tekrantz57/Drag/docs/CONTROLLER_FIRMWARE_UPDATE.md

# Controller Firmware Updates

DragWin can install bundled DragMC application firmware on a Mega 2560 or an
Arduino Due using its **Programming USB port only**. Each board has its own
validated package and uploader. On October 20, 2026, the operator successfully
flashed both the Due and an Elegoo Mega through DragWin on native Windows.
Due updater support is current-source work, not included in beta.2 downloads;
Due/bossac Wine qualification and deliberate failure/recovery tests remain pending.

## Operator Workflow

Current source checks the identified controller against its board's validated
bundled firmware package, offline. If the bundled version is newer, a persistent
amber notice below the connection controls shows the board and installed/available
versions, with **Update firmware...** opening the same updater as the File menu.
This feature is not in the beta.2 downloads. Nothing is automatically flashed.

Mega and Due versions are compared separately and numerically. Equal/newer
controllers, unidentified/unsupported products, unparseable versions, missing
packages, and ambiguous packages do not receive a guessed update offer. Package
validation failures are recorded in controller activity without a popup. Reconnect
to retry a check after repairing the local package files. Due light-test and Due
race firmware are different product version series; migration remains available
through the File menu rather than a misleading numeric update comparison.

The notice disappears on disconnect and is suppressed in demo mode. It stays
visible, but its update action is disabled, while update safety checks fail.
The File menu follows the same checks: close practice/tournament/diagnostic
windows, finish any known armed/running pass, and wait for a fresh idle heartbeat.
An idle-looking heartbeat does not clear an arm acknowledged earlier in the same
connection. An unidentified sketch can still use explicit manual board selection.
The updater rechecks controller safety after tool acquisition before releasing USB.

1. Connect the controller by USB and select its COM port in DragWin. For Due,
   use the connector nearest the round power jack, not Native USB. The current
   bench PC uses COM21 for Due Programming and COM26 for the Elegoo Mega;
   COM24 is the Due Native connector. Port numbers are machine-specific.
2. Close Practice Pass Results. Tournament and Sensor Test windows must also
   be closed before returning to the main window.
3. Choose **File > Update Controller Firmware...**.
4. Verify the displayed board, DragMC version, and COM port.
5. If DragWin cannot identify the existing sketch, explicitly choose the board
   type and physically confirm it is on the selected port. Nothing is selected
   by default. A known incompatible identity is rejected instead of overridden.
6. Keep USB connected while DragWin writes, verifies, reconnects, and requests
   the expected DragMC identity.

The update has three possible outcomes:

- **Updated:** the uploader verified flash and DragWin received the expected
  product, version, and MCU identity (Mega `DRAG_MC`/`MEGA2560`, Due
  `DRAG_MC_DUE`/`SAM3X8E`).
- **Written but not confirmed:** the uploader verified flash, but DragWin did not
  receive the expected identity within 20 seconds. Check the selected port and
  power-cycle the controller. This is not reported as a confirmed update.
- **Failed:** no successful upload was reported. DragWin shows the useful final
  uploader output and attempts to reopen the previous serial connection.

For Due, the 1200-baud Programming-port reset/erase occurs before bossac writes.
An interrupted update can leave no application running; repeat the upload with
DragWin's explicit board confirmation or Arduino IDE/CLI. The current firmware
version need not increase for an intentional reinstall. Both the full Due race
identity and the older light-only Due sketch select the Due **race** package;
updating replaces the diagnostic sketch, not the board's ROM bootloader.

## Supported Recovery

The updater supports a Mega that has its normal bootloader but currently runs
no DragMC sketch, a different sketch, or an application damaged by an
interrupted upload. Compatible clones are supported when their USB-to-serial
interface exposes a working COM port and their bootloader implements the Mega
`wiring` upload protocol.

The updater cannot repair a missing or damaged bootloader. Restore that with an
ISP programmer and Arduino tooling before using DragWin. The normal updater
never writes a `with_bootloader.hex` image and never disables the ATmega2560
signature check or flash verification.

The Due path uses its Programming-port interface and SAM ROM bootloader. It
does not implement Native USB port discovery/re-enumeration or any native Linux
uploader. Never select a Mega package for a Due or a Due package for a Mega.

## Uploader Acquisition

DragWin uses `avrdude.exe` and `avrdude.conf` as a matched pair. It checks, in
order:

1. `DRAGWIN_AVRDUDE_PATH` and optional `DRAGWIN_AVRDUDE_CONFIG` development
   overrides.
2. `%LOCALAPPDATA%\dragWin\Tools\avrdude\8.0.0-arduino1`.
3. avrdude installations under Arduino package directories.
4. The pinned official Arduino Windows archive, downloaded only after the
   operator approves the firmware-update confirmation.

The official archive's byte count and SHA-256 are pinned in source and checked
before extraction. avrdude is GPL-licensed; source and license information are
available from [the avrdude project](https://github.com/avrdudes/avrdude). The
tool archive is supplied by [Arduino Downloads](https://downloads.arduino.cc/).

Due updates use **bossac 1.6.1-arduino**, the version declared by Arduino SAM
Boards 1.6.12. Lookup order is `DRAGWIN_BOSSAC_PATH` (development override),
`%LOCALAPPDATA%\dragWin\Tools\bossac\1.6.1-arduino`, then that exact installed
Arduino tool version. Otherwise DragWin downloads the official Windows archive
after confirmation, verifies its pinned size (222,918 bytes) and SHA-256, and
extracts only `bossac.exe`. The override must be compatible with the SAM
Programming-port recipe; arbitrary newer bossac versions are not auto-selected.
No Arduino IDE installation is needed when downloading the pinned uploader.

## Wine Compatibility

The results below qualify only the **Mega/avrdude** path. The new Due/bossac
workflow, its 1200-baud reset, and its 32-bit Windows uploader need separate
Wine qualification on both Intel and ARM64 Linux.

The updater has been verified from the self-contained Windows x64 DragWin
release under Wine 11 on an Intel Linux system. In the tested setup, the Mega
appeared as `/dev/ttyACM0` and was mapped to `COM33` in the default Wine prefix:

```bash
ln -s /dev/ttyACM0 ~/.wine/dosdevices/com33
```

DragWin connected through `COM33`, downloaded and validated the pinned Windows
`avrdude` archive, and successfully flashed the bundled DragMC firmware. A
different Wine prefix or COM number can be used by changing the symlink path
and selecting the corresponding port in DragWin. The Linux account must have
permission to open the underlying serial device.

The separate Windows ARM64 DragWin release has also been verified running
natively under ARM64 Wine 11 on a Rock 5B, without x64 emulation or CPU
translation for DragWin itself. From that ARM64 environment, DragWin also
connected through `COM1`, downloaded and validated the pinned Windows `avrdude`
package, and successfully updated the controller firmware. That uploader is the
pinned Windows 32-bit `avrdude.exe` and ran under Wine; the update did not use
native Linux avrdude.

## Developer Packaging

Firmware versioning is defined in `dragMC/FirmwareVersion.h`. Build the current
Mega package from the repository root:

```powershell
powershell.exe -NoProfile -ExecutionPolicy Bypass -File `
  .\tools\Build-ControllerFirmware.ps1 `
  -ArduinoCliPath "C:\Program Files\Arduino CLI\arduino-cli.exe"
# Also build the independent Due package:
.\tools\Build-ControllerFirmware.ps1 -Board Due
```

The script:

- requires the installed `arduino:avr` core;
- compiles `arduino:avr:mega:cpu=atmega2560`;
- selects only `dragMC.ino.hex`;
- validates the version source and captures the core version;
- records the image byte count and SHA-256;
- writes `dragMC/dist/DragMC-mega-<version>.dragfw`; and
- leaves ignored build intermediates under `artifacts/controller-firmware`.

The `.dragfw` ZIP contains exactly `manifest.json` and `dragMC.ino.hex`.
DragWin validates its product, board profile, MCU, uploader settings, image
name, size, SHA-256, Intel HEX records, checksums, and EOF before releasing the
COM port. Publishing fails when the package matching `FirmwareVersion.h` is
absent. Build and commit the generated package with the exact firmware source
that produced it.

`-Board Due` requires the `arduino:sam` core and compiles
`arduino:sam:arduino_due_x_dbg`. Its version comes from
`DRAGMC_DUE_FIRMWARE_VERSION` in the same header. It packages only
`dragMC.ino.bin` as `DragMC-due-<version>.dragfw`, leaving Mega packages intact.
Due manifests are whitelisted separately, including product/MCU, Programming
Port FQBN, bossac backend and reset baud. DragWin checks the BIN size, hash and
SAM3X8E stack/reset vectors; a HEX, Native USB profile, wrong board tuple,
malformed image, duplicate package or cross-board selection is rejected before
upload. Publish now requires packages matching both firmware version macros.
