tekrantz57/Drag/docs/BUILDING.md

# Building From Source

Drag is distributed as source and as experimental self-contained Windows beta
packages through GitHub Releases. See [Try It Without Hardware](TRY_DEMO.md).

## Prerequisites

- .NET 10 SDK on Windows.
- Arduino CLI.
- Arduino AVR Boards core for the Mega 2560.
- Visual Studio is optional.

Install or update the Arduino index and AVR core:

```powershell
arduino-cli core update-index
arduino-cli core install arduino:avr
```

## Windows Application

From the repository root:

```powershell
dotnet restore dragWin\dragWin.sln
dotnet build dragWin\dragWin.sln -c Release --no-restore
dotnet run --project dragWin\dragWin.ProtocolTests\dragWin.ProtocolTests.csproj -c Release --no-build
dotnet format dragWin\dragWin.sln --verify-no-changes --no-restore
python -m unittest tools\test_drag_speech_helper.py
```

The protocol runner includes tournament UI, dial-input, and interrupted-round
recovery regression tests. CI also compiles a host harness against the actual
Mega sketch to test result delivery with a full queue and slow serial output:

```sh
g++ -std=c++17 -I tools/firmware-tests tools/firmware-tests/results.cpp -o /tmp/drag-firmware-tests
/tmp/drag-firmware-tests
```

These host tests exercise firmware logic with simulated pins and serial;
physical timing and electrical behavior still require track testing.

Run DragWin from source with:

```powershell
dotnet run --project dragWin\dragWin.csproj -c Release
```

## Mega Firmware

Compile the sketch directly:

```powershell
arduino-cli compile --fqbn arduino:avr:mega:cpu=atmega2560 dragMC
```

Create the versioned application-only `.dragfw` package used by DragWin:

```powershell
powershell.exe -NoProfile -ExecutionPolicy Bypass -File `
  .\tools\Build-ControllerFirmware.ps1
```

The packaging script reads `dragMC/FirmwareVersion.h`, compiles the Mega image,
records its size and SHA-256, validates the package metadata, and writes the
matching file under `dragMC/dist`. Commit a changed package only with the exact
firmware source that produced it.

## Local Self-Contained Builds

These commands create local test folders; they do not create an official Drag
release:

```powershell
dotnet publish dragWin\dragWin.csproj -c Release -r win-x64 `
  --self-contained true -p:PublishSingleFile=false `
  -o artifacts\release\DragWin-win-x64

dotnet publish dragWin\dragWin.csproj -c Release -r win-arm64 `
  --self-contained true -p:PublishSingleFile=false `
  -o artifacts\release\DragWin-win-arm64
```

Keep the complete publish directory together. DragWin expects its .NET runtime,
native SQLite library, `Firmware` directory, and packaged
`Linux/drag-speech-helper.py` to remain beside the executable. Piper itself and
voice models are optional external installations and are not published by Drag.

## Clean-Clone Check

Before treating a commit as a public validation point:

1. Build the solution in Release configuration.
2. Run the protocol tests and formatting check.
3. Compile and package DragMC for the Mega 2560.
4. Confirm the source tree contains no database, log, report, backup, credential,
   IDE-user, or machine-local files.
5. Follow only the commands in this document from a clean checkout.

## Tagged Beta Packages

After validation, commit the version and release notes and tag that exact
commit (for example, `v0.10.0-beta.1`). From that clean, tagged checkout:

```powershell
powershell.exe -NoProfile -ExecutionPolicy Bypass -File .\tools\Build-Release.ps1
```

The script publishes self-contained x64 and ARM64 folders, adds the demo
launcher, simple getting-started notes, licenses and source-commit metadata,
rejects personal data and debugging files, and creates ZIPs plus SHA-256
checksums under a fresh `artifacts/release` directory. It does not upload,
create tags, or edit the source. Attach only the ZIPs and checksum file to a
GitHub prerelease, using the matching release-notes document.

Validate each package with `tools/Test-ReleasePackage.ps1`, passing its ZIP and
the generated checksum file. Add `-LaunchDemo` for x64 startup testing on an x64
Windows host. Current packages must also contain the beta feedback notes and
commissioning worksheet. Inspect ARM64 packages here, then runtime-test them on
an ARM64 machine before claiming that platform has been validated.

To retain non-private report fixtures for print QA, set `DRAG_REPORT_TEST_OUTPUT`
to a local output folder before running the protocol tests. The test runner
writes a normal demo report and a 120-row long-name print stress report there.
