tekrantz57/Drag/docs/TROUBLESHOOTING.md

# Troubleshooting

## Controller Port Does Not Appear

Close Arduino Serial Monitor and any other program using the Mega, reconnect
USB, select **Refresh ports**, and choose the resulting COM port in DragWin.
Only one process can own the serial port at a time.

Under Wine, map the Linux serial device into the Wine prefix and select that COM
name in DragWin. For example:

```bash
ln -s /dev/ttyACM0 ~/.wine/dosdevices/com33
```

The COM number is local configuration, not a Drag requirement. Testing used
`COM33` on Intel Linux and `COM1` on the ARM64 Rock 5B. The Linux account must
have permission to open the underlying `/dev/ttyACM*` or `/dev/ttyUSB*` device.

## Sensor Randomly Shows Blocked

The installed LM393 sensors are active-HIGH. An unwired Mega input can float
and appear blocked. Connect the sensor output and common ground, or install the
documented 10k pulldown from the Mega input node to ground. Disable optional
interval sensors for lanes where they are not physically installed.

## Sensor Test Changes But A Pass Does Not Complete

Confirm that only the intended lanes participate and that the required beams
occur in race order: staging, launch, speed trap, then finish. In
`BOTH_BLOCKED`, pre-stage and stage must be blocked together. `IN_ORDER` is a
manual-testing alternative that latches pre-stage before stage.

Use Sensor Test to inspect each input's raw blocked-edge count and most recent
blocked-pulse duration. Firmware 0.6.6 and earlier require 2 ms qualification
for speed-trap and finish, which rejected short pulses during venue testing.
Current source firmware 0.6.7 captures their first sampled blocked edges and
latches each race timestamp once. Staging and interval inputs remain debounced.

In Sensor Test, reset counts before a test, note edge-count increments and pulse
widths, then click Read Scan Timing afterward (protocol 10+). The requested
maximum scan-start gap and scan duration help assess polling; they do not prove
that an electrical pulse was produced or guarantee that every pulse was sampled.
If no raw edge is captured, investigate optical/electrical output versus polling
with a scope or logic analyzer. Restore normal A2/A3 wiring before timed passes
if the inputs were swapped for diagnosis.

## Tree Lights Stay On Or Off During Light Test

The Mega's D22-D53 double-row header has two +5V positions immediately before
D22 and D23. Use the labels printed on the board instead of treating the end of
the connector as D22/D23. LEDs accidentally connected to the +5V pair remain on
regardless of Light Tree Test commands, while a jumper on the wrong digital pin
may remain off or respond to a different control.

Confirm questionable outputs by moving a known-working LED and resistor to the
labeled pin, or measure the pin relative to Mega GND while toggling it. Keep the
Light Tree Test window open during measurement; after it closes, D22 and D23
return to their normal pre-stage and stage sensor behavior.

## Status Or Diagnostic Frames Are Missing

Open Controller Diagnostics or press the appropriate status command in the
main window. The serial log records traffic that was actually requested or sent;
simply opening the serial log does not continuously request every diagnostic
frame.

## Firmware Update Cannot Identify The Existing Sketch

The updater can recover a Mega with a normal USB bootloader even if it runs a
different sketch. Physically verify that the selected port belongs to the Mega
before using the manual confirmation path. The updater cannot repair a missing
or damaged bootloader; that requires an ISP programmer and Arduino tooling.

See [Controller Firmware Updates](CONTROLLER_FIRMWARE_UPDATE.md) for uploader
selection, validation, recovery boundaries, and Wine results.

## Voice Is Unavailable Under Wine

DragWin can use SAPI voices installed in the Wine prefix, Piper, or the
packaged native Linux eSpeak NG helper. See
[Linux Speech Under Wine](LINUX_SPEECH.md) for engine selection and eSpeak
diagnostics. Speech is optional and an unavailable engine does not affect race
timing or controller operation.

## No Piper Voices Appear

Installing `piper-tts` does not install a voice. Download both the `.onnx`
model and `.onnx.json` configuration into Drag's Piper voice directory. On
native Windows, confirm that `python` starts the environment where Piper was
installed. Under Wine, start the helper natively with `--engine piper --port
38593` before opening Race and Track Settings.

If Piper was installed with pipx, system `python3` cannot import it. Run the
helper with `$(pipx environment --value PIPX_LOCAL_VENVS)/piper-tts/bin/python`,
or use the dedicated virtual environment described in
[Piper Speech](PIPER_SPEECH.md).

## Sharing Diagnostics

Serial logs, reports, databases, and screenshots can contain racer names, car
names, local paths, and controller activity. Remove private information before
sharing excerpts.
