tekrantz57/Drag/dragMC/dragMC.ino

#include <Arduino.h>
#include <limits.h>
#include "FirmwareVersion.h"
#include "BoardProfile.h"
#ifdef DRAG_DUE_CAPTURE
#include "DueBeamSensor.h"
#endif

namespace {

constexpr uint8_t MAX_LANE_COUNT = 4;
constexpr uint8_t LIGHTS_PER_LANE = 7;
constexpr uint8_t SENSORS_PER_LANE = 6;
constexpr const char* FIRMWARE_NAME = DragBoard::Product;
constexpr const char* FIRMWARE_VERSION = DragBoard::Version;
constexpr uint8_t PROTOCOL_VERSION = 11;

enum LightIndex : uint8_t {
  PreStageLight,
  StageLight,
  AmberLight1,
  AmberLight2,
  AmberLight3,
  GreenLight,
  RedLight
};

enum SensorIndex : uint8_t {
  PreStageSensor,
  StageSensor,
  Split1Sensor,
  Split2Sensor,
  SpeedTrapSensor,
  FinishSensor
};

constexpr const char* SENSOR_NAMES[SENSORS_PER_LANE] = {
    "PRESTAGE", "STAGE", "INTERVAL_1", "INTERVAL_2", "SPEED_TRAP", "FINISH"};

using DragBoard::LIGHT_PINS;
using DragBoard::SENSOR_PINS;

constexpr unsigned long DEFAULT_TRACK_LENGTH_IN_X1000 = 660000;
constexpr unsigned long DEFAULT_SPEED_TRAP_LENGTH_IN_X1000 = 12000;
constexpr unsigned long MIN_TRACK_LENGTH_IN_X1000 = 1000;
constexpr unsigned long MAX_TRACK_LENGTH_IN_X1000 = 10000000;
constexpr unsigned long MIN_SPEED_TRAP_LENGTH_IN_X1000 = 100;
// LM393 slot sensors used on this track drive the digital output HIGH when the
// beam is blocked and LOW when it is clear.
constexpr bool SENSOR_IS_ACTIVE_LOW = false;
constexpr unsigned long SENSOR_DEBOUNCE_MS = 2;
constexpr unsigned long DEFAULT_STAGED_DELAY_MS = 500;
constexpr unsigned long MAX_STAGED_DELAY_MS = 5000;
constexpr unsigned long FULL_TREE_INTERVAL_MS = 500;
constexpr unsigned long PRO_TREE_INTERVAL_MS = 400;
constexpr unsigned long RESULT_HOLD_MS = 3000;
constexpr unsigned long TRACK_CLEAR_HOLD_MS = 1000;
constexpr unsigned long MAX_RACE_TIME_MS = 30000;
constexpr unsigned long MIN_DIAL_MS = 100;
constexpr unsigned long MAX_DIAL_MS = 60000;
constexpr unsigned long DEFAULT_DIAL_MS = 10000;
constexpr uint8_t SERIAL_QUEUE_CAPACITY = 24;
constexpr uint8_t SERIAL_FRAME_SIZE = 136;
constexpr uint8_t MAX_SERIAL_INPUT_BYTES_PER_LOOP = 32;
constexpr uint8_t SERIAL_DIAGNOSTIC_RESERVED_SLOTS = 4;
constexpr unsigned long HEARTBEAT_INTERVAL_MS = 1000;
constexpr unsigned long SENSOR_MONITOR_LEASE_MS = 3000;
constexpr uint32_t ALL_SENSOR_BITS =
    (1UL << (MAX_LANE_COUNT * SENSORS_PER_LANE)) - 1;

enum class RaceMode : uint8_t { HeadsUp, Bracket };
enum class TreeMode : uint8_t { Full, Pro };
enum class StagingMode : uint8_t { BothBlocked, InOrder };
enum class TreeState : uint8_t {
  WaitingForAllLanes,
  StagingHold,
  RaceActive,
  ShowingResults,
  WaitingForClear
};
enum class LaneTreeStep : uint8_t {
  Waiting,
  ProAmbers,
  Amber1,
  Amber2,
  Amber3,
  Green
};

#ifdef DRAG_DUE_CAPTURE
using DebouncedBeamSensor = DragDue::BeamSensor;
#else
class DebouncedBeamSensor {
 public:
  void begin(const uint8_t pin) {
    pin_ = pin;
    pinMode(pin_, SENSOR_IS_ACTIVE_LOW ? INPUT_PULLUP : INPUT);
    rawBlocked_ = readRawBlocked();
    blocked_ = rawBlocked_;
    const unsigned long nowUs = micros();
    rawChangedAtMs_ = millis();
    rawChangedAtUs_ = nowUs;
    rawPulseStartedAtUs_ = nowUs;
  }

  bool update(const unsigned long nowMs, const bool immediate = false) {
    const unsigned long nowUs = micros();
    becameBlocked_ = false;
    becameUnblocked_ = false;
    bool changed = false;

    const bool newRawBlocked = readRawBlocked();
    if (newRawBlocked != rawBlocked_) {
      changed = true;
      if (newRawBlocked) {
        if (blockedEdgeCount_ < ULONG_MAX) ++blockedEdgeCount_;
        rawPulseStartedAtUs_ = nowUs;
      } else {
        lastRawPulseWidthUs_ = nowUs - rawPulseStartedAtUs_;
        hasCompletedRawPulse_ = true;
      }
      rawBlocked_ = newRawBlocked;
      rawChangedAtMs_ = nowMs;
      rawChangedAtUs_ = nowUs;
    }

    if (blocked_ == rawBlocked_ ||
        (!immediate && nowMs - rawChangedAtMs_ < SENSOR_DEBOUNCE_MS)) {
      return changed;
    }

    blocked_ = rawBlocked_;
    if (blocked_) {
      blockedAtUs_ = rawChangedAtUs_;
      becameBlocked_ = true;
    } else {
      unblockedAtUs_ = rawChangedAtUs_;
      becameUnblocked_ = true;
    }
    return true;
  }

  bool isBlocked() const { return blocked_; }
  bool becameBlocked() const { return becameBlocked_; }
  bool becameUnblocked() const { return becameUnblocked_; }
  unsigned long blockedAtUs() const { return blockedAtUs_; }
  unsigned long unblockedAtUs() const { return unblockedAtUs_; }
  bool isRawBlocked() const { return rawBlocked_; }
  unsigned long blockedEdgeCount() const { return blockedEdgeCount_; }
  bool hasCompletedRawPulse() const { return hasCompletedRawPulse_; }
  unsigned long lastRawPulseWidthUs() const { return lastRawPulseWidthUs_; }

  void resetDiagnostics() {
    blockedEdgeCount_ = 0;
    lastRawPulseWidthUs_ = 0;
    hasCompletedRawPulse_ = false;
    if (rawBlocked_) rawPulseStartedAtUs_ = micros();
  }

 private:
  bool readRawBlocked() const {
    const bool inputIsHigh = digitalRead(pin_) == HIGH;
    return SENSOR_IS_ACTIVE_LOW ? !inputIsHigh : inputIsHigh;
  }

  uint8_t pin_ = 0;
  bool rawBlocked_ = false;
  bool blocked_ = false;
  bool becameBlocked_ = false;
  bool becameUnblocked_ = false;
  unsigned long rawChangedAtMs_ = 0;
  unsigned long rawChangedAtUs_ = 0;
  unsigned long blockedAtUs_ = 0;
  unsigned long unblockedAtUs_ = 0;
  unsigned long rawPulseStartedAtUs_ = 0;
  unsigned long blockedEdgeCount_ = 0;
  unsigned long lastRawPulseWidthUs_ = 0;
  bool hasCompletedRawPulse_ = false;
};
#endif

struct LaneRace {
  bool fouled = false;
  bool launched = false;
  bool crossedSplit1 = false;
  bool crossedSplit2 = false;
  bool crossedSpeedTrap = false;
  bool finished = false;
  bool elapsedAvailable = false;
  bool reactionAvailable = false;
  LaneTreeStep treeStep = LaneTreeStep::Waiting;
  int32_t reactionUs = 0;
  unsigned long greenAtUs = 0;
  unsigned long launchedAtUs = 0;
  unsigned long split1AtUs = 0;
  unsigned long split2AtUs = 0;
  unsigned long speedTrapAtUs = 0;
  unsigned long finishedAtUs = 0;
  unsigned long elapsedUs = 0;
};

DebouncedBeamSensor sensors[MAX_LANE_COUNT][SENSORS_PER_LANE];
LaneRace lanes[MAX_LANE_COUNT];
unsigned long dialMs[MAX_LANE_COUNT] = {
    DEFAULT_DIAL_MS, DEFAULT_DIAL_MS, DEFAULT_DIAL_MS, DEFAULT_DIAL_MS};
unsigned long trackLengthInX1000 = DEFAULT_TRACK_LENGTH_IN_X1000;
unsigned long speedTrapLengthInX1000 =
    DEFAULT_SPEED_TRAP_LENGTH_IN_X1000;

RaceMode raceMode = RaceMode::HeadsUp;
TreeMode treeMode = TreeMode::Full;
StagingMode stagingMode = StagingMode::BothBlocked;
unsigned long stagedDelayMs = DEFAULT_STAGED_DELAY_MS;
bool starterButtonMode = false;
bool startAuthorized = false;
uint16_t stagingToken = 0;
uint8_t activeLaneCount = MAX_LANE_COUNT;
uint8_t heatLaneMask = 0x0F;
uint8_t splitLaneMask = 0;
TreeState treeState = TreeState::WaitingForAllLanes;
unsigned long stateStartedAtMs = 0;
unsigned long raceEpochMs = 0;
unsigned long raceEpochUs = 0;
unsigned long slowestDialMs = DEFAULT_DIAL_MS;
bool preStageLatched[MAX_LANE_COUNT] = {};
char serialOutputQueue[SERIAL_QUEUE_CAPACITY][SERIAL_FRAME_SIZE];
uint8_t serialQueueHead = 0;
uint8_t serialQueueTail = 0;
uint8_t serialQueueCount = 0;
uint8_t serialHeadOffset = 0;
unsigned int droppedSerialMessageCount = 0;
uint32_t protocolSequence = 0;
unsigned long lastHeartbeatAtMs = 0;
#ifndef DRAG_DUE_CAPTURE
bool heartbeatQuiet = false;
#endif
uint32_t pendingSensorDiagnosticMask = 0;
unsigned long sensorMonitorRenewedAtMs = 0;
uint8_t sensorDiagnosticCursor = 0;
bool sensorMonitorEnabled = false;
uint8_t sensorMonitorLaneMask = 0x0F;
#ifdef DRAG_DUE_CAPTURE
bool dueRaceCaptureArmed = false;
#endif
unsigned long previousScanStartedUs = 0;
unsigned long maximumScanGapUs = 0;
unsigned long maximumScanDurationUs = 0;
bool scanTimingAvailable = false;
bool lightTestEnabled = false;
bool raceResultsPending = false;
uint8_t resultLaneCursor = 0;
uint8_t resultFieldCursor[MAX_LANE_COUNT] = {};
uint8_t resultPlaceCursor = 0;
uint8_t placementCount = 0;
uint8_t placementLanes[MAX_LANE_COUNT] = {};

void formatHeatLanes(char* destination, const size_t destinationSize);
void formatSplitLanes(char* destination, const size_t destinationSize);
const char* treeStateName();
void refreshSensorCaptureScope();
void armSensorCapture();

uint8_t calculateChecksum(const char* payload) {
  uint8_t checksum = 0;
  while (*payload != '\0') {
    checksum ^= static_cast<uint8_t>(*payload++);
  }
  return checksum;
}

bool messageGetsSequenceMetadata(const char* payload) {
  return strncmp(payload, "EVENT:", 6) == 0 ||
         strncmp(payload, "RESULT:", 7) == 0;
}

bool queueProtocolMessage(const char* payload) {
  if (serialQueueCount >= SERIAL_QUEUE_CAPACITY) {
    return false;
  }

  char sequencedPayload[SERIAL_FRAME_SIZE - 4];
  const char* payloadToSend = payload;
  if (messageGetsSequenceMetadata(payload)) {
    snprintf(
        sequencedPayload,
        sizeof(sequencedPayload),
        "%s:SEQ:%lu:MS:%lu",
        payload,
        static_cast<unsigned long>(++protocolSequence),
        millis());
    payloadToSend = sequencedPayload;
  }

  const uint8_t checksum = calculateChecksum(payloadToSend);
  snprintf(
      serialOutputQueue[serialQueueTail],
      SERIAL_FRAME_SIZE,
      "%s:%02X\n",
      payloadToSend,
      checksum);
  serialQueueTail = (serialQueueTail + 1) % SERIAL_QUEUE_CAPACITY;
  ++serialQueueCount;
  return true;
}

void sendProtocolMessage(const char* payload) {
  if (!queueProtocolMessage(payload) && droppedSerialMessageCount < UINT_MAX) {
    ++droppedSerialMessageCount;
  }
}

void sendFlashProtocolMessage(PGM_P payload) {
  char message[32];
  strncpy_P(message, payload, sizeof(message) - 1);
  message[sizeof(message) - 1] = '\0';
  sendProtocolMessage(message);
}

void sendHello() {
  char heatLanes[10];
  char message[112];
  formatHeatLanes(heatLanes, sizeof(heatLanes));
  snprintf(
      message,
      sizeof(message),
      "HELLO:%s:%s:PROTO:%u:MCU:%s:LANES:%u:HEAT_LANES:%s",
      FIRMWARE_NAME,
      FIRMWARE_VERSION,
      PROTOCOL_VERSION,
      DragBoard::Mcu,
      activeLaneCount,
      heatLanes);
  sendProtocolMessage(message);
}

void sendHeartbeat(const unsigned long nowMs) {
  char message[96];
  snprintf_P(
      message,
      sizeof(message),
      PSTR("HEARTBEAT:%lu:SEQ:%lu:STATE:%s:START_TOKEN:%u"),
      nowMs,
      static_cast<unsigned long>(protocolSequence),
      treeStateName(), stagingToken);
  sendProtocolMessage(message);
}

void updateHeartbeat(const unsigned long nowMs) {
#ifndef DRAG_DUE_CAPTURE
  const bool quiet = treeState == TreeState::RaceActive ||
      (treeState == TreeState::StagingHold && (!starterButtonMode || startAuthorized));
  if (quiet) {
    if (!heartbeatQuiet) {
      heartbeatQuiet = true;
      sendFlashProtocolMessage(PSTR("EVENT:TREE:HEARTBEAT_QUIET"));
    }
    return;
  }
  if (heartbeatQuiet) {
    heartbeatQuiet = false;
    lastHeartbeatAtMs = nowMs;
    sendHeartbeat(nowMs);
    return;
  }
#endif
  if (nowMs - lastHeartbeatAtMs < HEARTBEAT_INTERVAL_MS) return;
  lastHeartbeatAtMs = nowMs;
  sendHeartbeat(nowMs);
}

void queueDroppedMessageWarning() {
  if (droppedSerialMessageCount == 0 ||
      serialQueueCount >= SERIAL_QUEUE_CAPACITY) {
    return;
  }

  const unsigned int droppedCount = droppedSerialMessageCount;
  droppedSerialMessageCount = 0;
  char message[48];
  snprintf(
      message,
      sizeof(message),
      "ERROR:SERIAL_QUEUE_DROPPED:%u",
      droppedCount);
  sendProtocolMessage(message);
}

void serviceSerialOutput() {
  if (serialQueueCount == 0) {
    queueDroppedMessageWarning();
    return;
  }

  const int availableBytes = Serial.availableForWrite();
  if (availableBytes <= 0) return;

  const char* frame = serialOutputQueue[serialQueueHead];
  const size_t frameLength = strlen(frame);
  const size_t remainingBytes = frameLength - serialHeadOffset;
  const size_t bytesToWrite =
      min(remainingBytes, static_cast<size_t>(availableBytes));

  Serial.write(
      reinterpret_cast<const uint8_t*>(frame + serialHeadOffset),
      bytesToWrite);
  serialHeadOffset += bytesToWrite;

  if (serialHeadOffset < frameLength) return;

  serialHeadOffset = 0;
  serialQueueHead = (serialQueueHead + 1) % SERIAL_QUEUE_CAPACITY;
  --serialQueueCount;
  queueDroppedMessageWarning();
}

void sendLaneEvent(const uint8_t lane, const char* event) {
  char message[64];
  snprintf(message, sizeof(message), "EVENT:LANE:%u:%s", lane + 1, event);
  sendProtocolMessage(message);
}

uint8_t laneLightStates[MAX_LANE_COUNT] = {};

void setLaneLight(const uint8_t lane, const LightIndex light, const bool on) {
  const uint8_t mask = static_cast<uint8_t>(1U << light);
  if (((laneLightStates[lane] & mask) != 0) == on) return;
  if (on) laneLightStates[lane] |= mask;
  else laneLightStates[lane] &= static_cast<uint8_t>(~mask);
  digitalWrite(LIGHT_PINS[lane][light], on ? HIGH : LOW);
}

void turnOffLaneTree(const uint8_t lane) {
  setLaneLight(lane, AmberLight1, false);
  setLaneLight(lane, AmberLight2, false);
  setLaneLight(lane, AmberLight3, false);
  setLaneLight(lane, GreenLight, false);
}

void turnOffRaceLights() {
  for (uint8_t lane = 0; lane < MAX_LANE_COUNT; ++lane) {
    turnOffLaneTree(lane);
    setLaneLight(lane, RedLight, false);
  }
}

void resetLaneResults() {
  for (uint8_t lane = 0; lane < MAX_LANE_COUNT; ++lane) {
    lanes[lane] = LaneRace{};
    preStageLatched[lane] = false;
  }
}

void turnOffAllLights() {
  for (uint8_t lane = 0; lane < MAX_LANE_COUNT; ++lane) {
    for (uint8_t light = 0; light < LIGHTS_PER_LANE; ++light) {
      setLaneLight(lane, static_cast<LightIndex>(light), false);
    }
  }
}

const char* raceModeName() {
  return raceMode == RaceMode::HeadsUp ? "HEADS_UP" : "BRACKET";
}

const char* treeModeName() {
  return treeMode == TreeMode::Full ? "FULL" : "PRO";
}

const char* stagingModeName() {
  return stagingMode == StagingMode::BothBlocked
             ? "BOTH_BLOCKED"
             : "IN_ORDER";
}

unsigned long treeGreenDelayMs() {
  return treeMode == TreeMode::Full
             ? 3UL * FULL_TREE_INTERVAL_MS
             : PRO_TREE_INTERVAL_MS;
}

bool laneIsActive(const uint8_t lane) {
  return activeLaneCount == 4 || lane == 0 || lane == 3;
}

bool laneParticipates(const uint8_t lane) {
  return laneIsActive(lane) && (heatLaneMask & (1U << lane)) != 0;
}

bool laneHasSplitSensors(const uint8_t lane) {
  return (splitLaneMask & (1U << lane)) != 0;
}

uint8_t defaultHeatLaneMask() {
  return activeLaneCount == 4 ? 0x0F : 0x09;
}

void formatHeatLanes(char* destination, const size_t destinationSize) {
  destination[0] = '\0';
  for (uint8_t lane = 0; lane < MAX_LANE_COUNT; ++lane) {
    if (!laneParticipates(lane)) continue;
    char laneText[4];
    snprintf(laneText, sizeof(laneText), "%s%u",
             destination[0] == '\0' ? "" : ",", lane + 1);
    strncat(destination, laneText, destinationSize - strlen(destination) - 1);
  }
}

const char* treeStateName() {
  switch (treeState) {
    case TreeState::WaitingForAllLanes:
      return "WAITING_FOR_ALL_LANES";
    case TreeState::StagingHold:
      return starterButtonMode ? (startAuthorized ? "START_DELAY" : "WAITING_FOR_START")
                               : "ALL_LANES_STAGED";
    case TreeState::RaceActive:
      return "RACE_ACTIVE";
    case TreeState::ShowingResults:
      return "RACE_COMPLETE";
    case TreeState::WaitingForClear:
      return "WAITING_FOR_CLEAR";
  }
  return "UNKNOWN";
}

void calculateSlowestDial() {
  slowestDialMs = 0;
  for (uint8_t lane = 0; lane < MAX_LANE_COUNT; ++lane) {
    if (!laneParticipates(lane)) continue;
    if (dialMs[lane] > slowestDialMs) slowestDialMs = dialMs[lane];
  }
}

unsigned long laneDelayMs(const uint8_t lane) {
  return raceMode == RaceMode::Bracket ? slowestDialMs - dialMs[lane] : 0;
}

unsigned long latestLaneDelayMs() {
  unsigned long latestDelay = 0;
  for (uint8_t lane = 0; lane < MAX_LANE_COUNT; ++lane) {
    if (!laneParticipates(lane)) continue;
    const unsigned long delay = laneDelayMs(lane);
    if (delay > latestDelay) latestDelay = delay;
  }
  return latestDelay;
}

void enterState(const TreeState newState, const unsigned long nowMs) {
  treeState = newState;
  stateStartedAtMs = nowMs;

  switch (newState) {
    case TreeState::WaitingForAllLanes:
      startAuthorized = false;
      turnOffRaceLights();
      raceResultsPending = false;
      for (uint8_t lane = 0; lane < MAX_LANE_COUNT; ++lane) resultFieldCursor[lane] = 0;
      resultLaneCursor = 0;
      resetLaneResults();
      sendProtocolMessage("EVENT:TREE:WAITING_FOR_ALL_LANES");
      break;

    case TreeState::StagingHold:
      startAuthorized = false;
      if (++stagingToken == 0) ++stagingToken;
      sendProtocolMessage("EVENT:TREE:ALL_LANES_STAGED");
      if (starterButtonMode) {
        char message[48];
        snprintf_P(message, sizeof(message), PSTR("EVENT:TREE:WAITING_FOR_START:%u"), stagingToken);
        sendProtocolMessage(message);
      }
      break;

    case TreeState::RaceActive:
      calculateSlowestDial();
      raceEpochMs = nowMs;
      raceEpochUs = micros();
      sendProtocolMessage(
          raceMode == RaceMode::Bracket
              ? "EVENT:TREE:BRACKET_START"
              : "EVENT:TREE:HEADS_UP_START");
      break;

    case TreeState::ShowingResults:
#ifdef DRAG_DUE_CAPTURE
      dueRaceCaptureArmed = false;
#endif
      break;

    case TreeState::WaitingForClear:
      turnOffRaceLights();
      sendProtocolMessage("EVENT:TREE:WAITING_FOR_CLEAR");
      break;
  }
}

#ifdef DRAG_DUE_CAPTURE
bool laneHasCaptureFault(const uint8_t lane) {
  for (uint8_t sensor = 0; sensor < SENSORS_PER_LANE; ++sensor) {
    if ((sensor == Split1Sensor || sensor == Split2Sensor) && !laneHasSplitSensors(lane)) continue;
    if (sensors[lane][sensor].captureFault()) return true;
  }
  return false;
}
#endif

bool allLanesAreStaged() {
  for (uint8_t lane = 0; lane < MAX_LANE_COUNT; ++lane) {
    if (!laneParticipates(lane)) continue;
#ifdef DRAG_DUE_CAPTURE
    if (laneHasCaptureFault(lane)) return false;
#endif
    const bool preStageSatisfied =
        stagingMode == StagingMode::BothBlocked
            ? sensors[lane][PreStageSensor].isBlocked()
            : preStageLatched[lane];
    if (!preStageSatisfied || !sensors[lane][StageSensor].isBlocked()) {
      return false;
    }
  }
  return true;
}

void updateSequentialStaging() {
  if (lightTestEnabled || stagingMode != StagingMode::InOrder ||
      treeState != TreeState::WaitingForAllLanes) {
    return;
  }

  for (uint8_t lane = 0; lane < MAX_LANE_COUNT; ++lane) {
    if (!laneParticipates(lane) || preStageLatched[lane]) continue;
    if (sensors[lane][PreStageSensor].isBlocked() &&
        !sensors[lane][StageSensor].isBlocked()) {
      preStageLatched[lane] = true;
    }
  }
}

void formatSplitLanes(char* destination, const size_t destinationSize) {
  destination[0] = '\0';
  for (uint8_t lane = 0; lane < MAX_LANE_COUNT; ++lane) {
    if (!laneHasSplitSensors(lane)) continue;
    char laneText[4];
    snprintf(laneText, sizeof(laneText), "%s%u",
             destination[0] == '\0' ? "" : ",", lane + 1);
    strncat(destination, laneText, destinationSize - strlen(destination) - 1);
  }
  if (destination[0] == '\0') {
    strncat(destination, "NONE", destinationSize - 1);
  }
}

bool allLanesHaveResults() {
  for (uint8_t lane = 0; lane < MAX_LANE_COUNT; ++lane) {
    if (!laneParticipates(lane)) continue;
    if (!lanes[lane].fouled && !lanes[lane].finished) return false;
  }
  return true;
}

bool allSensorsAreClear() {
  for (uint8_t lane = 0; lane < MAX_LANE_COUNT; ++lane) {
    if (!laneParticipates(lane)) continue;
    for (uint8_t sensor = 0; sensor < SENSORS_PER_LANE; ++sensor) {
      if ((sensor == Split1Sensor || sensor == Split2Sensor) &&
          !laneHasSplitSensors(lane)) continue;
      if (sensors[lane][sensor].isBlocked()) return false;
    }
  }
  return true;
}

void updateStagingLights() {
  if (lightTestEnabled) return;
  for (uint8_t lane = 0; lane < MAX_LANE_COUNT; ++lane) {
    const bool active = laneParticipates(lane);
    setLaneLight(
        lane,
        PreStageLight,
        active &&
            (sensors[lane][PreStageSensor].isBlocked() ||
             (stagingMode == StagingMode::InOrder && preStageLatched[lane])));
    setLaneLight(
        lane,
        StageLight,
        active && sensors[lane][StageSensor].isBlocked());
  }
}

void foulLane(const uint8_t lane) {
  if (lanes[lane].fouled) return;
  lanes[lane].fouled = true;
  turnOffLaneTree(lane);
  setLaneLight(lane, RedLight, true);
  sendLaneEvent(lane, "FOUL");
}

void setLaneTreeStep(const uint8_t lane, const LaneTreeStep step) {
  LaneRace& result = lanes[lane];
  if (result.fouled || result.treeStep == step) return;

  turnOffLaneTree(lane);
  result.treeStep = step;
  char event[24];

  switch (step) {
    case LaneTreeStep::Waiting:
      return;
    case LaneTreeStep::ProAmbers:
      setLaneLight(lane, AmberLight1, true);
      setLaneLight(lane, AmberLight2, true);
      setLaneLight(lane, AmberLight3, true);
      strcpy(event, "PRO_AMBERS");
      break;
    case LaneTreeStep::Amber1:
      setLaneLight(lane, AmberLight1, true);
      strcpy(event, "AMBER_1");
      break;
    case LaneTreeStep::Amber2:
      setLaneLight(lane, AmberLight2, true);
      strcpy(event, "AMBER_2");
      break;
    case LaneTreeStep::Amber3:
      setLaneLight(lane, AmberLight3, true);
      strcpy(event, "AMBER_3");
      break;
    case LaneTreeStep::Green:
      setLaneLight(lane, GreenLight, true);
      result.greenAtUs =
          raceEpochUs +
          (laneDelayMs(lane) + treeGreenDelayMs()) * 1000UL;
      strcpy(event, "GREEN");
      break;
  }
  sendLaneEvent(lane, event);
}

void updateLaneTree(const uint8_t lane, const unsigned long nowMs) {
  if (lanes[lane].fouled) return;

  const unsigned long elapsedMs = nowMs - raceEpochMs;
  const unsigned long startMs = laneDelayMs(lane);

  if (elapsedMs < startMs) return;
  if (treeMode == TreeMode::Pro) {
    if (elapsedMs < startMs + PRO_TREE_INTERVAL_MS) {
      setLaneTreeStep(lane, LaneTreeStep::ProAmbers);
    } else {
      setLaneTreeStep(lane, LaneTreeStep::Green);
    }
    return;
  }

  if (elapsedMs < startMs + FULL_TREE_INTERVAL_MS) {
    setLaneTreeStep(lane, LaneTreeStep::Amber1);
  } else if (elapsedMs < startMs + 2UL * FULL_TREE_INTERVAL_MS) {
    setLaneTreeStep(lane, LaneTreeStep::Amber2);
  } else if (elapsedMs < startMs + 3UL * FULL_TREE_INTERVAL_MS) {
    setLaneTreeStep(lane, LaneTreeStep::Amber3);
  } else {
    setLaneTreeStep(lane, LaneTreeStep::Green);
  }
}

void prepareElapsedResult(const uint8_t lane) {
  LaneRace& result = lanes[lane];
  if (!result.launched) return;
  result.elapsedUs = result.finishedAtUs - result.launchedAtUs;
  result.elapsedAvailable = true;
}

void formatTrapSpeed(const uint8_t lane, char* message, const size_t size) {
  LaneRace& result = lanes[lane];

  if (!result.crossedSpeedTrap) {
    snprintf(
        message, size, "RESULT:LANE:%u:SPEED_UNAVAILABLE",
        lane + 1);
    return;
  }

  const unsigned long trapUs = result.finishedAtUs - result.speedTrapAtUs;
  if (trapUs == 0 || trapUs > MAX_RACE_TIME_MS * 1000UL) {
    snprintf(
        message, size, "RESULT:LANE:%u:SPEED_INVALID", lane + 1);
    return;
  }

  const float speedTrapInches = speedTrapLengthInX1000 / 1000.0F;
  const float mph =
      (speedTrapInches / (trapUs / 1000000.0F)) / 17.6F;
  snprintf(
      message, size, "RESULT:LANE:%u:SPEED_MPH_X100:%lu",
      lane + 1, static_cast<unsigned long>(mph * 100.0F + 0.5F));
}

void updateLaneRace(const uint8_t lane) {
#ifdef DRAG_DUE_CAPTURE
  if (laneHasCaptureFault(lane)) return;
#endif
  LaneRace& result = lanes[lane];
  if (result.fouled || result.finished) return;

  DebouncedBeamSensor& stage = sensors[lane][StageSensor];
  if (!result.launched && stage.becameUnblocked()) {
    const unsigned long launchUs = stage.unblockedAtUs();
    const unsigned long scheduledGreenUs =
        raceEpochUs +
        (laneDelayMs(lane) + treeGreenDelayMs()) * 1000UL;
    const int32_t reactionUs =
        static_cast<int32_t>(launchUs - scheduledGreenUs);

    result.greenAtUs = scheduledGreenUs;
    result.reactionUs = reactionUs;
    result.reactionAvailable = true;
    char message[48];
    snprintf(
        message, sizeof(message), "EVENT:LANE:%u:REACTION_US:%ld",
        lane + 1, static_cast<long>(reactionUs));
    sendProtocolMessage(message);

    if (reactionUs < 0) {
      foulLane(lane);
      return;
    }

    result.launchedAtUs = launchUs;
    result.launched = true;
  }

  if (result.launched && laneHasSplitSensors(lane)) {
    DebouncedBeamSensor& split1 = sensors[lane][Split1Sensor];
    if (!result.crossedSplit1 && split1.becameBlocked()) {
      result.split1AtUs = split1.blockedAtUs();
      result.crossedSplit1 = true;
      char message[56];
      snprintf(
          message, sizeof(message), "RESULT:LANE:%u:INTERVAL_1_US:%lu",
          lane + 1, result.split1AtUs - result.launchedAtUs);
      sendProtocolMessage(message);
    }

    DebouncedBeamSensor& split2 = sensors[lane][Split2Sensor];
    if (!result.crossedSplit2 && split2.becameBlocked()) {
      result.split2AtUs = split2.blockedAtUs();
      result.crossedSplit2 = true;
      char message[56];
      snprintf(
          message, sizeof(message), "RESULT:LANE:%u:INTERVAL_2_US:%lu",
          lane + 1, result.split2AtUs - result.launchedAtUs);
      sendProtocolMessage(message);
    }
  }

  DebouncedBeamSensor& trap = sensors[lane][SpeedTrapSensor];
  if (!result.crossedSpeedTrap && trap.becameBlocked()) {
    result.speedTrapAtUs = trap.blockedAtUs();
    result.crossedSpeedTrap = true;
    sendLaneEvent(lane, "SPEED_TRAP");
    if (result.launched) {
      char message[60];
      snprintf(
          message, sizeof(message), "RESULT:LANE:%u:SPEED_TRAP_US:%lu",
          lane + 1, result.speedTrapAtUs - result.launchedAtUs);
      sendProtocolMessage(message);
    }
  }

  DebouncedBeamSensor& finish = sensors[lane][FinishSensor];
  if (finish.becameBlocked()) {
    result.finishedAtUs = finish.blockedAtUs();
    result.finished = true;
    prepareElapsedResult(lane);
  }
}

enum class BracketResultClass : uint8_t {
  Legal,
  Breakout,
  RedLight,
  DidNotFinish
};

BracketResultClass bracketResultClass(const uint8_t lane) {
  const LaneRace& result = lanes[lane];
  if (result.fouled) return BracketResultClass::RedLight;
  if (!result.finished || !result.elapsedAvailable) {
    return BracketResultClass::DidNotFinish;
  }
  return result.elapsedUs < dialMs[lane] * 1000UL
             ? BracketResultClass::Breakout
             : BracketResultClass::Legal;
}

unsigned long redLightMagnitudeUs(const LaneRace& result) {
  if (!result.reactionAvailable || result.reactionUs >= 0) return ULONG_MAX;
  return static_cast<unsigned long>(
      -static_cast<int64_t>(result.reactionUs));
}

bool bracketLaneRanksAhead(const uint8_t candidate, const uint8_t current) {
  const BracketResultClass candidateClass = bracketResultClass(candidate);
  const BracketResultClass currentClass = bracketResultClass(current);
  if (candidateClass != currentClass) {
    return static_cast<uint8_t>(candidateClass) <
           static_cast<uint8_t>(currentClass);
  }

  const LaneRace& candidateResult = lanes[candidate];
  const LaneRace& currentResult = lanes[current];
  switch (candidateClass) {
    case BracketResultClass::Legal:
      return candidateResult.finishedAtUs - raceEpochUs <
             currentResult.finishedAtUs - raceEpochUs;
    case BracketResultClass::Breakout: {
      const unsigned long candidateBreakout =
          dialMs[candidate] * 1000UL - candidateResult.elapsedUs;
      const unsigned long currentBreakout =
          dialMs[current] * 1000UL - currentResult.elapsedUs;
      if (candidateBreakout != currentBreakout) {
        return candidateBreakout < currentBreakout;
      }
      return candidateResult.finishedAtUs - raceEpochUs <
             currentResult.finishedAtUs - raceEpochUs;
    }
    case BracketResultClass::RedLight: {
      const unsigned long candidateMagnitude =
          redLightMagnitudeUs(candidateResult);
      const unsigned long currentMagnitude = redLightMagnitudeUs(currentResult);
      if (candidateMagnitude != currentMagnitude) {
        return candidateMagnitude < currentMagnitude;
      }
      return candidate < current;
    }
    case BracketResultClass::DidNotFinish:
      return candidate < current;
  }
  return false;
}

void prepareRaceResults() {
  placementCount = 0;
  resultPlaceCursor = 0;
  raceResultsPending = true;

  if (raceMode == RaceMode::HeadsUp) {
    bool used[MAX_LANE_COUNT] = {};
    uint8_t place = 1;
    for (; place <= activeLaneCount; ++place) {
      int8_t bestLane = -1;
      unsigned long bestFinishOffset = 0;
      for (uint8_t lane = 0; lane < MAX_LANE_COUNT; ++lane) {
        if (!laneParticipates(lane)) continue;
        if (used[lane] || lanes[lane].fouled || !lanes[lane].finished) continue;
        const unsigned long offset = lanes[lane].finishedAtUs - raceEpochUs;
        if (bestLane < 0 || offset < bestFinishOffset) {
          bestLane = lane;
          bestFinishOffset = offset;
        }
      }
      if (bestLane < 0) break;
      used[bestLane] = true;
      placementLanes[placementCount++] = bestLane;
    }
    return;
  }

  bool used[MAX_LANE_COUNT] = {};
  while (true) {
    int8_t bestLane = -1;
    for (uint8_t lane = 0; lane < MAX_LANE_COUNT; ++lane) {
      if (!laneParticipates(lane) || used[lane] ||
          bracketResultClass(lane) == BracketResultClass::DidNotFinish) {
        continue;
      }
      if (bestLane < 0 || bracketLaneRanksAhead(lane, bestLane)) {
        bestLane = lane;
      }
    }
    if (bestLane < 0) break;
    used[bestLane] = true;
    placementLanes[placementCount++] = bestLane;
  }

}

// Final results are retried a frame at a time; polling continues while serial drains.
void serviceRaceResults() {
  if ((treeState != TreeState::RaceActive && !raceResultsPending) ||
      serialQueueCount >= SERIAL_QUEUE_CAPACITY) return;
  char message[64];
  message[0] = '\0';
  for (uint8_t offset = 0; offset < MAX_LANE_COUNT; ++offset) {
    const uint8_t lane = (resultLaneCursor + offset) % MAX_LANE_COUNT;
    const LaneRace& result = lanes[lane];
    if (!laneParticipates(lane) ||
        (!raceResultsPending && !result.finished && !result.fouled)) continue;
    while (resultFieldCursor[lane] < 9) {
      switch (resultFieldCursor[lane]) {
        case 0:
          if (result.reactionAvailable) snprintf(message, sizeof(message),
              "EVENT:LANE:%u:REACTION_US:%ld", lane + 1, static_cast<long>(result.reactionUs));
          break;
        case 1:
          if (result.fouled) snprintf(message, sizeof(message), "EVENT:LANE:%u:FOUL", lane + 1);
          break;
        case 2:
        case 3:
          if (laneHasSplitSensors(lane) && !result.fouled) {
            const bool first = resultFieldCursor[lane] == 2;
            const bool crossed = first ? result.crossedSplit1 : result.crossedSplit2;
            const unsigned long atUs = first ? result.split1AtUs : result.split2AtUs;
            if (crossed) snprintf(message, sizeof(message), "RESULT:LANE:%u:INTERVAL_%u_US:%lu",
                lane + 1, first ? 1 : 2, atUs - result.launchedAtUs);
            else snprintf(message, sizeof(message), "RESULT:LANE:%u:INTERVAL_%u_UNAVAILABLE",
                lane + 1, first ? 1 : 2);
          }
          break;
        case 4:
          if (result.launched && result.crossedSpeedTrap) snprintf(message, sizeof(message),
              "RESULT:LANE:%u:SPEED_TRAP_US:%lu", lane + 1, result.speedTrapAtUs - result.launchedAtUs);
          break;
        case 5:
          if (result.finished) {
            if (result.elapsedAvailable) snprintf(message, sizeof(message),
                "RESULT:LANE:%u:ELAPSED_US:%lu", lane + 1, result.elapsedUs);
            else snprintf(message, sizeof(message), "RESULT:LANE:%u:ELAPSED_UNAVAILABLE", lane + 1);
          }
          break;
        case 6:
          if (result.elapsedAvailable) {
            if (raceMode == RaceMode::Bracket && result.elapsedUs < dialMs[lane] * 1000UL)
              snprintf(message, sizeof(message), "RESULT:LANE:%u:BREAKOUT_US:%lu",
                  lane + 1, dialMs[lane] * 1000UL - result.elapsedUs);
            else snprintf(message, sizeof(message), "RESULT:LANE:%u:VALID", lane + 1);
          }
          break;
        case 7:
          if (result.finished) formatTrapSpeed(lane, message, sizeof(message));
          break;
        case 8:
          if (!result.fouled && !result.finished) snprintf(message, sizeof(message), "RESULT:LANE:%u:DNF", lane + 1);
          break;
      }
      if (message[0] != '\0') {
        if (queueProtocolMessage(message)) ++resultFieldCursor[lane];
        resultLaneCursor = (lane + 1) % MAX_LANE_COUNT;
        return;
      }
      ++resultFieldCursor[lane];
    }
  }

  if (!raceResultsPending) return;
  if (resultPlaceCursor < placementCount) {
    snprintf(message, sizeof(message), "RESULT:PLACE:%u:LANE:%u",
        resultPlaceCursor + 1, placementLanes[resultPlaceCursor] + 1);
  } else if (resultPlaceCursor == placementCount) {
    if (placementCount == 0) strcpy(message, "RESULT:NO_WINNER");
    else if (raceMode == RaceMode::Bracket) snprintf(message, sizeof(message),
        "RESULT:WINNER:LANE:%u", placementLanes[0] + 1);
  } else {
    strcpy(message, "EVENT:TREE:RACE_COMPLETE");
  }
  if (message[0] == '\0' || queueProtocolMessage(message)) {
    if (resultPlaceCursor > placementCount) {
      raceResultsPending = false;
      stateStartedAtMs = millis();
    }
    ++resultPlaceCursor;
  }
}

void sendStatus() {
  char message[132];
  char heatLanes[10];
  formatHeatLanes(heatLanes, sizeof(heatLanes));
  snprintf(
      message,
      sizeof(message),
      "STATUS:TREE:%s:MODE:%s:LANES:%u:HEAT_LANES:%s:TRACK_IN_X1000:%lu:TRAP_IN_X1000:%lu",
      treeStateName(),
      raceModeName(),
      activeLaneCount,
      heatLanes,
      trackLengthInX1000,
      speedTrapLengthInX1000);
  sendProtocolMessage(message);

  snprintf(
      message, sizeof(message),
      "STATUS:SETTINGS:TREE:%s:STAGED_DELAY_MS:%lu:STAGING_MODE:%s",
      treeModeName(), stagedDelayMs, stagingModeName());
  sendProtocolMessage(message);

  char splitLanes[10];
  snprintf_P(message, sizeof(message),
      PSTR("STATUS:START_MODE:%s:START_TOKEN:%u:AUTHORIZED:%u"),
      starterButtonMode ? "MANUAL" : "AUTO", stagingToken, startAuthorized ? 1 : 0);
  sendProtocolMessage(message);
  formatSplitLanes(splitLanes, sizeof(splitLanes));
  snprintf(message, sizeof(message), "STATUS:INTERVAL_LANES:%s", splitLanes);
  sendProtocolMessage(message);

  for (uint8_t lane = 0; lane < MAX_LANE_COUNT; ++lane) {
    snprintf(
        message, sizeof(message),
        "STATUS:LANE:%u:DIAL_MS:%lu:PRESTAGE:%u:PRESTAGE_LATCHED:%u:STAGE:%u:SPEED_TRAP:%u:FINISH:%u:FOUL:%u:FINISHED:%u",
        lane + 1, dialMs[lane],
        sensors[lane][PreStageSensor].isBlocked() ? 1 : 0,
        preStageLatched[lane] ? 1 : 0,
        sensors[lane][StageSensor].isBlocked() ? 1 : 0,
        sensors[lane][SpeedTrapSensor].isBlocked() ? 1 : 0,
        sensors[lane][FinishSensor].isBlocked() ? 1 : 0,
        lanes[lane].fouled ? 1 : 0,
        lanes[lane].finished ? 1 : 0);
    sendProtocolMessage(message);
    snprintf(
        message, sizeof(message),
        "STATUS:INTERVALS:LANE:%u:ENABLED:%u:INTERVAL_1:%u:INTERVAL_2:%u",
        lane + 1,
        laneHasSplitSensors(lane) ? 1 : 0,
        sensors[lane][Split1Sensor].isBlocked() ? 1 : 0,
        sensors[lane][Split2Sensor].isBlocked() ? 1 : 0);
    sendProtocolMessage(message);
  }
}

uint8_t sensorBitIndex(const uint8_t lane, const uint8_t sensor) {
  return lane * SENSORS_PER_LANE + sensor;
}

bool sensorIsInstalled(const uint8_t lane, const uint8_t sensor) {
  return (sensor != Split1Sensor && sensor != Split2Sensor) ||
         laneHasSplitSensors(lane);
}

void refreshSensorCaptureScope() {
#ifdef DRAG_DUE_CAPTURE
  for (uint8_t lane = 0; lane < MAX_LANE_COUNT; ++lane) {
    const bool wanted = !lightTestEnabled && (dueRaceCaptureArmed ? laneParticipates(lane) :
        sensorMonitorEnabled && (sensorMonitorLaneMask & (1U << lane)) != 0);
    for (uint8_t sensor = 0; sensor < SENSORS_PER_LANE; ++sensor)
      sensors[lane][sensor].setEnabled(wanted && sensorIsInstalled(lane, sensor));
  }
#endif
}

void armSensorCapture() {
#ifdef DRAG_DUE_CAPTURE
  for (uint8_t lane = 0; lane < MAX_LANE_COUNT; ++lane)
    for (uint8_t sensor = 0; sensor < SENSORS_PER_LANE; ++sensor)
      sensors[lane][sensor].setEnabled(false);
  dueRaceCaptureArmed = true;
#endif
}

bool sensorIsMonitored(const uint8_t lane, const uint8_t sensor) {
  return (sensorMonitorLaneMask & (1U << lane)) != 0 && sensorIsInstalled(lane, sensor);
}

uint32_t installedSensorBits() {
  uint32_t bits = 0;
  for (uint8_t lane = 0; lane < MAX_LANE_COUNT; ++lane) {
    for (uint8_t sensor = 0; sensor < SENSORS_PER_LANE; ++sensor) {
      if (sensorIsMonitored(lane, sensor)) {
        bits |= 1UL << sensorBitIndex(lane, sensor);
      }
    }
  }
  return bits;
}

void queueSensorDiagnosticSnapshot(const bool includeUninstalled) {
  uint32_t bits = 0;
  for (uint8_t lane = 0; lane < MAX_LANE_COUNT; ++lane)
    if ((sensorMonitorLaneMask & (1U << lane)) != 0)
      for (uint8_t sensor = 0; sensor < SENSORS_PER_LANE; ++sensor)
        if (includeUninstalled || sensorIsInstalled(lane, sensor)) bits |= 1UL << sensorBitIndex(lane, sensor);
  pendingSensorDiagnosticMask |= bits;
}

void queueChangedSensorDiagnostic(const uint8_t lane, const uint8_t sensor) {
  if (!sensorMonitorEnabled || !sensorIsMonitored(lane, sensor)) return;
  pendingSensorDiagnosticMask |= 1UL << sensorBitIndex(lane, sensor);
}

void serviceSensorDiagnostics() {
  if (raceResultsPending || pendingSensorDiagnosticMask == 0 ||
      serialQueueCount >=
          SERIAL_QUEUE_CAPACITY - SERIAL_DIAGNOSTIC_RESERVED_SLOTS) {
    return;
  }

  constexpr uint8_t sensorTotal = MAX_LANE_COUNT * SENSORS_PER_LANE;
  for (uint8_t offset = 0; offset < sensorTotal; ++offset) {
    const uint8_t bitIndex = (sensorDiagnosticCursor + offset) % sensorTotal;
    const uint32_t bit = 1UL << bitIndex;
    if ((pendingSensorDiagnosticMask & bit) == 0) continue;

    const uint8_t lane = bitIndex / SENSORS_PER_LANE;
    const uint8_t sensor = bitIndex % SENSORS_PER_LANE;
    const DebouncedBeamSensor& beam = sensors[lane][sensor];
    const uint8_t installed = sensorIsInstalled(lane, sensor) ? 1 : 0;
#ifdef DRAG_DUE_CAPTURE
    const uint8_t capture = beam.isEnabled() && !beam.captureFault() ? 1 : 0;
#else
    const uint8_t capture = 1;
#endif
    char message[132];
    if (beam.hasCompletedRawPulse()) {
      snprintf_P(
          message, sizeof(message),
          PSTR("SENSOR:%u:%s:INSTALLED:%u:CAPTURE:%u:BLOCKED:%u:RAW:%u:EDGES:%lu:PULSE_US:%lu"),
          lane + 1,
          SENSOR_NAMES[sensor],
          installed,
          capture,
          beam.isBlocked() ? 1 : 0,
          beam.isRawBlocked() ? 1 : 0,
          beam.blockedEdgeCount(),
          beam.lastRawPulseWidthUs());
    } else {
      snprintf_P(
          message, sizeof(message),
          PSTR("SENSOR:%u:%s:INSTALLED:%u:CAPTURE:%u:BLOCKED:%u:RAW:%u:EDGES:%lu:PULSE_US:NONE"),
          lane + 1,
          SENSOR_NAMES[sensor],
          installed,
          capture,
          beam.isBlocked() ? 1 : 0,
          beam.isRawBlocked() ? 1 : 0,
          beam.blockedEdgeCount());
    }

    if (!queueProtocolMessage(message)) return;
    pendingSensorDiagnosticMask &= ~bit;
    sensorDiagnosticCursor = (bitIndex + 1) % sensorTotal;
    return;
  }
}

void startSensorMonitor(const unsigned long nowMs) {
  sensorMonitorRenewedAtMs = nowMs;
  if (sensorMonitorEnabled) return;
  sensorMonitorEnabled = true;
  refreshSensorCaptureScope();
  queueSensorDiagnosticSnapshot(true);
  sendFlashProtocolMessage(PSTR("ACK:SENSOR_MONITOR:START"));
}

void stopSensorMonitor() {
  sensorMonitorEnabled = false;
  pendingSensorDiagnosticMask = 0;
  refreshSensorCaptureScope();
  sendFlashProtocolMessage(PSTR("ACK:SENSOR_MONITOR:STOP"));
}

void updateSensorMonitor(const unsigned long nowMs) {
  if (!sensorMonitorEnabled ||
      nowMs - sensorMonitorRenewedAtMs < SENSOR_MONITOR_LEASE_MS) {
    return;
  }
  sensorMonitorEnabled = false;
  pendingSensorDiagnosticMask = 0;
  refreshSensorCaptureScope();
}

bool tryParseLightName(const char* value, LightIndex& light) {
  if (strcmp_P(value, PSTR("PRESTAGE")) == 0) {
    light = PreStageLight;
  } else if (strcmp_P(value, PSTR("STAGE")) == 0) {
    light = StageLight;
  } else if (strcmp_P(value, PSTR("AMBER_1")) == 0) {
    light = AmberLight1;
  } else if (strcmp_P(value, PSTR("AMBER_2")) == 0) {
    light = AmberLight2;
  } else if (strcmp_P(value, PSTR("AMBER_3")) == 0) {
    light = AmberLight3;
  } else if (strcmp_P(value, PSTR("GREEN")) == 0) {
    light = GreenLight;
  } else if (strcmp_P(value, PSTR("RED")) == 0) {
    light = RedLight;
  } else {
    return false;
  }
  return true;
}

void stopLightTest(const bool acknowledge) {
  lightTestEnabled = false;
  turnOffAllLights();
  if (acknowledge) sendFlashProtocolMessage(PSTR("ACK:LIGHT_TEST:STOP"));
}

void processLightTestCommand(char* line) {
  if (strcmp_P(line, PSTR("LIGHT_TEST:START")) == 0) {
    if (!lightTestEnabled && treeState != TreeState::WaitingForAllLanes) {
      sendProtocolMessage("ERROR:STATE:RACE_ACTIVE");
      return;
    }
    if (!lightTestEnabled) {
      lightTestEnabled = true;
      turnOffAllLights();
    }
    sendFlashProtocolMessage(PSTR("ACK:LIGHT_TEST:START"));
    return;
  }

  if (strcmp_P(line, PSTR("LIGHT_TEST:STOP")) == 0) {
    stopLightTest(true);
    return;
  }

  if (!lightTestEnabled) {
    sendFlashProtocolMessage(PSTR("ERROR:STATE:LIGHT_TEST_INACTIVE"));
    return;
  }

  if (strcmp_P(line, PSTR("LIGHT_TEST:OFF")) == 0) {
    turnOffAllLights();
    sendFlashProtocolMessage(PSTR("ACK:LIGHT_TEST:OFF"));
    return;
  }

  char* savePointer = nullptr;
  char* command = strtok_r(line, ":", &savePointer);
  char* operation = strtok_r(nullptr, ":", &savePointer);
  char* laneText = strtok_r(nullptr, ":", &savePointer);
  char* lightText = strtok_r(nullptr, ":", &savePointer);
  char* stateText = strtok_r(nullptr, ":", &savePointer);
  char* extra = strtok_r(nullptr, ":", &savePointer);
  if (command == nullptr || operation == nullptr || laneText == nullptr ||
      lightText == nullptr || stateText == nullptr || extra != nullptr ||
      strcmp_P(command, PSTR("LIGHT_TEST")) != 0 ||
      strcmp_P(operation, PSTR("SET")) != 0) {
    sendFlashProtocolMessage(PSTR("ERROR:COMMAND:LIGHT_TEST"));
    return;
  }

  char* laneEnd = nullptr;
  const long laneNumber = strtol(laneText, &laneEnd, 10);
  LightIndex light = PreStageLight;
  if (laneEnd == laneText || *laneEnd != '\0' ||
      laneNumber < 1 || laneNumber > MAX_LANE_COUNT) {
    sendFlashProtocolMessage(PSTR("ERROR:VALUE:LIGHT_TEST_LANE"));
    return;
  }
  if (!tryParseLightName(lightText, light)) {
    sendFlashProtocolMessage(PSTR("ERROR:VALUE:LIGHT_TEST_LIGHT"));
    return;
  }
  if (strcmp(stateText, "0") != 0 && strcmp(stateText, "1") != 0) {
    sendFlashProtocolMessage(PSTR("ERROR:VALUE:LIGHT_TEST_STATE"));
    return;
  }

  setLaneLight(
      static_cast<uint8_t>(laneNumber - 1), light, stateText[0] == '1');
  char message[64];
  snprintf(
      message, sizeof(message), "ACK:LIGHT_TEST:SET:%ld:%s:%s",
      laneNumber, lightText, stateText);
  sendProtocolMessage(message);
}

void sendSensorDiagnostics() {
  // Compatibility snapshot. Frames are emitted incrementally by the main loop.
  queueSensorDiagnosticSnapshot(false);
}

void resetSensorDiagnostics() {
  maximumScanGapUs = maximumScanDurationUs = 0;
  scanTimingAvailable = false;
  for (uint8_t lane = 0; lane < MAX_LANE_COUNT; ++lane) {
    for (uint8_t sensor = 0; sensor < SENSORS_PER_LANE; ++sensor) {
      sensors[lane][sensor].resetDiagnostics();
    }
  }
  if (sensorMonitorEnabled) queueSensorDiagnosticSnapshot(true);
}

int8_t hexValue(const char value) {
  if (value >= '0' && value <= '9') return value - '0';
  if (value >= 'A' && value <= 'F') return value - 'A' + 10;
  if (value >= 'a' && value <= 'f') return value - 'a' + 10;
  return -1;
}

bool settingsCanChange() {
  return treeState == TreeState::WaitingForAllLanes ||
         treeState == TreeState::ShowingResults ||
         treeState == TreeState::WaitingForClear;
}

void processSetCommand(char* line) {
  if (!settingsCanChange()) {
    sendProtocolMessage("ERROR:STATE:RACE_ACTIVE");
    return;
  }

  char* savePointer = nullptr;
  char* setPart = strtok_r(line, ":", &savePointer);
  char* setting = strtok_r(nullptr, ":", &savePointer);
  char* value1 = strtok_r(nullptr, ":", &savePointer);
  char* value2 = strtok_r(nullptr, ":", &savePointer);
  char* extra = strtok_r(nullptr, ":", &savePointer);

  if (setPart == nullptr || strcmp(setPart, "SET") != 0 ||
      setting == nullptr || value1 == nullptr || extra != nullptr) {
    sendProtocolMessage("ERROR:COMMAND:SET");
    return;
  }

  if (strcmp(setting, "MODE") == 0 && value2 == nullptr) {
    if (strcmp(value1, "HEADS_UP") == 0) {
      raceMode = RaceMode::HeadsUp;
    } else if (strcmp(value1, "BRACKET") == 0) {
      raceMode = RaceMode::Bracket;
    } else {
      sendProtocolMessage("ERROR:VALUE:MODE");
      return;
    }
    char message[32];
    snprintf(message, sizeof(message), "ACK:SET:MODE:%s", raceModeName());
    sendProtocolMessage(message);
    return;
  }

  if (strcmp(setting, "TREE") == 0 && value2 == nullptr) {
    if (strcmp(value1, "FULL") == 0) {
      treeMode = TreeMode::Full;
    } else if (strcmp(value1, "PRO") == 0) {
      treeMode = TreeMode::Pro;
    } else {
      sendProtocolMessage("ERROR:VALUE:TREE");
      return;
    }
    char message[32];
    snprintf(message, sizeof(message), "ACK:SET:TREE:%s", treeModeName());
    sendProtocolMessage(message);
    return;
  }

  if (strcmp_P(setting, PSTR("START_MODE")) == 0 && value2 == nullptr) {
    if (treeState == TreeState::RaceActive || treeState == TreeState::ShowingResults) {
      sendFlashProtocolMessage(PSTR("ERROR:STATE:START_MODE"));
      return;
    }
    if (strcmp_P(value1, PSTR("MANUAL")) == 0) starterButtonMode = true;
    else if (strcmp_P(value1, PSTR("AUTO")) == 0) starterButtonMode = false;
    else {
      sendFlashProtocolMessage(PSTR("ERROR:VALUE:START_MODE"));
      return;
    }
    enterState(TreeState::WaitingForAllLanes, millis());
    sendFlashProtocolMessage(starterButtonMode ? PSTR("ACK:SET:START_MODE:MANUAL")
                                               : PSTR("ACK:SET:START_MODE:AUTO"));
    return;
  }

  if (strcmp(setting, "STAGED_DELAY") == 0 && value2 == nullptr) {
    char* endPointer = nullptr;
    const unsigned long requestedDelay = strtoul(value1, &endPointer, 10);
    if (value1[0] == '\0' || endPointer == nullptr || *endPointer != '\0' ||
        requestedDelay > MAX_STAGED_DELAY_MS) {
      sendProtocolMessage("ERROR:VALUE:STAGED_DELAY");
      return;
    }
    stagedDelayMs = requestedDelay;
    char message[40];
    snprintf(
        message, sizeof(message), "ACK:SET:STAGED_DELAY:%lu",
        stagedDelayMs);
    sendProtocolMessage(message);
    return;
  }

  if (strcmp(setting, "STAGING_MODE") == 0 && value2 == nullptr) {
    if (strcmp(value1, "BOTH_BLOCKED") == 0) {
      stagingMode = StagingMode::BothBlocked;
    } else if (strcmp(value1, "IN_ORDER") == 0) {
      stagingMode = StagingMode::InOrder;
    } else {
      sendProtocolMessage("ERROR:VALUE:STAGING_MODE");
      return;
    }
    for (uint8_t lane = 0; lane < MAX_LANE_COUNT; ++lane) {
      preStageLatched[lane] = false;
    }
    updateStagingLights();
    char message[44];
    snprintf(
        message, sizeof(message), "ACK:SET:STAGING_MODE:%s",
        stagingModeName());
    sendProtocolMessage(message);
    return;
  }

  if (strcmp(setting, "LANES") == 0 && value2 == nullptr) {
    const unsigned long requestedCount = strtoul(value1, nullptr, 10);
    if (requestedCount != 2 && requestedCount != 4) {
      sendProtocolMessage("ERROR:VALUE:LANES");
      return;
    }
    activeLaneCount = requestedCount;
    heatLaneMask = defaultHeatLaneMask();
    turnOffRaceLights();
    updateStagingLights();
    char message[24];
    snprintf(
        message, sizeof(message), "ACK:SET:LANES:%u", activeLaneCount);
    sendProtocolMessage(message);
    return;
  }

  if (strcmp(setting, "HEAT_LANES") == 0 && value2 == nullptr) {
    uint8_t requestedMask = 0;
    char* laneSavePointer = nullptr;
    char* laneText = strtok_r(value1, ",", &laneSavePointer);
    while (laneText != nullptr) {
      const unsigned long laneNumber = strtoul(laneText, nullptr, 10);
      if (laneNumber < 1 || laneNumber > MAX_LANE_COUNT ||
          !laneIsActive(laneNumber - 1) ||
          (requestedMask & (1U << (laneNumber - 1))) != 0) {
        sendProtocolMessage("ERROR:VALUE:HEAT_LANES");
        return;
      }
      requestedMask |= 1U << (laneNumber - 1);
      laneText = strtok_r(nullptr, ",", &laneSavePointer);
    }
    if (requestedMask == 0) {
      sendProtocolMessage("ERROR:VALUE:HEAT_LANES");
      return;
    }
    heatLaneMask = requestedMask;
    turnOffRaceLights();
    updateStagingLights();
    char heatLanes[10];
    char message[36];
    formatHeatLanes(heatLanes, sizeof(heatLanes));
    snprintf(message, sizeof(message), "ACK:SET:HEAT_LANES:%s", heatLanes);
    sendProtocolMessage(message);
    return;
  }

  if (strcmp(setting, "INTERVAL_LANES") == 0 && value2 == nullptr) {
    uint8_t requestedMask = 0;
    if (strcmp(value1, "NONE") != 0) {
      char* laneSavePointer = nullptr;
      char* laneText = strtok_r(value1, ",", &laneSavePointer);
      while (laneText != nullptr) {
        const unsigned long laneNumber = strtoul(laneText, nullptr, 10);
        if (laneNumber < 1 || laneNumber > MAX_LANE_COUNT ||
            (requestedMask & (1U << (laneNumber - 1))) != 0) {
          sendProtocolMessage("ERROR:VALUE:INTERVAL_LANES");
          return;
        }
        requestedMask |= 1U << (laneNumber - 1);
        laneText = strtok_r(nullptr, ",", &laneSavePointer);
      }
      if (requestedMask == 0) {
        sendProtocolMessage("ERROR:VALUE:INTERVAL_LANES");
        return;
      }
    }

    splitLaneMask = requestedMask;
    if (sensorMonitorEnabled) queueSensorDiagnosticSnapshot(true);
    char splitLanes[10];
    char message[40];
    formatSplitLanes(splitLanes, sizeof(splitLanes));
    snprintf(message, sizeof(message), "ACK:SET:INTERVAL_LANES:%s", splitLanes);
    sendProtocolMessage(message);
    return;
  }

  if (strcmp(setting, "DISTANCES") == 0 && value2 != nullptr) {
    const unsigned long requestedTrackLength = strtoul(value1, nullptr, 10);
    const unsigned long requestedTrapLength = strtoul(value2, nullptr, 10);
    if (requestedTrackLength < MIN_TRACK_LENGTH_IN_X1000 ||
        requestedTrackLength > MAX_TRACK_LENGTH_IN_X1000 ||
        requestedTrapLength < MIN_SPEED_TRAP_LENGTH_IN_X1000 ||
        requestedTrapLength >= requestedTrackLength) {
      sendProtocolMessage("ERROR:VALUE:DISTANCES");
      return;
    }

    trackLengthInX1000 = requestedTrackLength;
    speedTrapLengthInX1000 = requestedTrapLength;
    char message[72];
    snprintf(
        message,
        sizeof(message),
        "ACK:SET:DISTANCES:%lu:%lu",
        trackLengthInX1000,
        speedTrapLengthInX1000);
    sendProtocolMessage(message);
    return;
  }

  if (strcmp(setting, "DIAL") == 0 && value2 != nullptr) {
    const unsigned long laneNumber = strtoul(value1, nullptr, 10);
    const unsigned long valueMs = strtoul(value2, nullptr, 10);
    if (laneNumber < 1 || laneNumber > MAX_LANE_COUNT ||
        !laneIsActive(laneNumber - 1) ||
        valueMs < MIN_DIAL_MS || valueMs > MAX_DIAL_MS) {
      sendProtocolMessage("ERROR:VALUE:DIAL");
      return;
    }
    dialMs[laneNumber - 1] = valueMs;
    char message[48];
    snprintf(
        message, sizeof(message), "ACK:SET:DIAL:%lu:%lu",
        laneNumber, valueMs);
    sendProtocolMessage(message);
    return;
  }

  sendProtocolMessage("ERROR:COMMAND:SET");
}

void processCommand(char* line) {
  char* checksumSeparator = strrchr(line, ':');
  if (checksumSeparator == nullptr || strlen(checksumSeparator + 1) != 2) {
    sendProtocolMessage("ERROR:CHECKSUM");
    return;
  }

  const int8_t high = hexValue(checksumSeparator[1]);
  const int8_t low = hexValue(checksumSeparator[2]);
  if (high < 0 || low < 0) {
    sendProtocolMessage("ERROR:CHECKSUM");
    return;
  }

  const uint8_t received = static_cast<uint8_t>((high << 4) | low);
  *checksumSeparator = '\0';
  if (received != calculateChecksum(line)) {
    sendProtocolMessage("ERROR:CHECKSUM");
    return;
  }

  if (strcmp_P(line, PSTR("ARM:MANUAL")) == 0 || strcmp_P(line, PSTR("ARM:AUTO")) == 0) {
    armSensorCapture();
    starterButtonMode = line[4] == 'M';
    stopLightTest(false);
    enterState(TreeState::WaitingForAllLanes, millis());
    refreshSensorCaptureScope();
    sendFlashProtocolMessage(starterButtonMode ? PSTR("ACK:ARM:MANUAL") : PSTR("ACK:ARM:AUTO"));
  } else if (strncmp_P(line, PSTR("START_TREE:"), 11) == 0) {
    char* end = nullptr;
    const unsigned long token = strtoul(line + 11, &end, 10);
    if (!starterButtonMode || lightTestEnabled || treeState != TreeState::StagingHold ||
        startAuthorized || !allLanesAreStaged() || end == line + 11 || *end != '\0' ||
        token != stagingToken) {
      sendFlashProtocolMessage(PSTR("ERROR:STATE:START_TREE"));
      return;
    }
    startAuthorized = true;
    stateStartedAtMs = millis();
    sendFlashProtocolMessage(PSTR("ACK:START_TREE"));
    sendFlashProtocolMessage(PSTR("EVENT:TREE:START_AUTHORIZED"));
  } else if (strcmp(line, "PING") == 0) {
    sendProtocolMessage("ACK:PING");
  } else if (strcmp(line, "IDENTIFY") == 0) {
    sendHello();
  } else if (strcmp(line, "STATUS") == 0) {
    sendStatus();
  } else if (strcmp_P(line, PSTR("SCAN_DIAGNOSTICS")) == 0) {
    char message[100];
    snprintf_P(message, sizeof(message),
        PSTR("STATUS:SCAN:MAX_GAP_US:%lu:MAX_DURATION_US:%lu"),
        maximumScanGapUs, maximumScanDurationUs);
    sendProtocolMessage(message);
  } else if (strcmp(line, "SENSOR_DIAGNOSTICS") == 0) {
    sendSensorDiagnostics();
  } else if (strcmp_P(line, PSTR("SENSOR_MONITOR:START")) == 0) {
    const bool changed = sensorMonitorLaneMask != 0x0F;
    sensorMonitorLaneMask = 0x0F;
    startSensorMonitor(millis());
    refreshSensorCaptureScope();
    if (changed) queueSensorDiagnosticSnapshot(true);
  } else if (strncmp_P(line, PSTR("SENSOR_MONITOR:START:"), 21) == 0) {
    const char* list = line + 21;
    uint8_t mask = 0;
    bool valid = strcmp(list, "NONE") == 0;
    if (!valid) {
      valid = *list != '\0';
      while (*list && valid) {
        if (*list < '1' || *list > '4') { valid = false; break; }
        const uint8_t bit = 1U << (*list++ - '1');
        if (mask & bit) { valid = false; break; }
        mask |= bit;
        if (*list == '\0') break;
        if (*list++ != ',' || *list == '\0') valid = false;
      }
    }
    if (!valid) { sendProtocolMessage("ERROR:VALUE:SENSOR_MONITOR"); return; }
    const bool changed = sensorMonitorLaneMask != mask;
    sensorMonitorLaneMask = mask;
    if (changed) pendingSensorDiagnosticMask = 0;
    startSensorMonitor(millis());
    refreshSensorCaptureScope();
    if (changed) queueSensorDiagnosticSnapshot(true);
  } else if (strcmp_P(line, PSTR("SENSOR_MONITOR:STOP")) == 0) {
    stopSensorMonitor();
  } else if (strcmp(line, "RESET_SENSOR_DIAGNOSTICS") == 0) {
    resetSensorDiagnostics();
    sendProtocolMessage("ACK:RESET_SENSOR_DIAGNOSTICS");
  } else if (strcmp(line, "RESET") == 0) {
    armSensorCapture();
    stopLightTest(false);
    sendProtocolMessage("ACK:RESET");
    enterState(TreeState::WaitingForAllLanes, millis());
    refreshSensorCaptureScope();
  } else if (strncmp_P(line, PSTR("LIGHT_TEST:"), 11) == 0) {
    processLightTestCommand(line);
  } else if (strncmp(line, "SET:", 4) == 0) {
    processSetCommand(line);
  } else {
    char message[112];
    snprintf(message, sizeof(message), "ERROR:COMMAND:%s", line);
    sendProtocolMessage(message);
  }
}

void updateSerialCommands() {
  static char buffer[96];
  static uint8_t length = 0;
  static bool overflowed = false;
  static bool invalidCharacters = false;

  uint8_t processedByteCount = 0;
  while (Serial.available() > 0 &&
         processedByteCount < MAX_SERIAL_INPUT_BYTES_PER_LOOP) {
    ++processedByteCount;
    const char value = static_cast<char>(Serial.read());
    if (value == '\r') continue;

    if (value == '\n') {
      if (invalidCharacters) {
        sendProtocolMessage("ERROR:COMMAND:INVALID_CHARACTERS");
      } else if (overflowed) {
        sendProtocolMessage("ERROR:COMMAND:TOO_LONG");
      } else if (length > 0) {
        buffer[length] = '\0';
        processCommand(buffer);
      }
      length = 0;
      overflowed = false;
      invalidCharacters = false;
      continue;
    }

    const uint8_t byteValue = static_cast<uint8_t>(value);
    if (byteValue < 0x20 || byteValue > 0x7E) {
      if (length > 0) invalidCharacters = true;
      continue;
    }
    if (overflowed || invalidCharacters) continue;
    if (length >= sizeof(buffer) - 1) {
      overflowed = true;
      continue;
    }
    buffer[length++] = value;
  }
}

void updateTree(const unsigned long nowMs) {
#ifdef DRAG_DUE_CAPTURE
  if (!dueRaceCaptureArmed && (treeState == TreeState::WaitingForAllLanes ||
      treeState == TreeState::StagingHold || treeState == TreeState::RaceActive)) return;
#endif
  if (lightTestEnabled) return;
  switch (treeState) {
    case TreeState::WaitingForAllLanes:
      if (allLanesAreStaged()) enterState(TreeState::StagingHold, nowMs);
      break;

    case TreeState::StagingHold:
      if (!allLanesAreStaged()) {
        sendProtocolMessage("EVENT:TREE:STAGING_ABORTED");
        enterState(TreeState::WaitingForAllLanes, nowMs);
      } else if ((!starterButtonMode || startAuthorized) &&
                 nowMs - stateStartedAtMs >= stagedDelayMs) {
        enterState(TreeState::RaceActive, nowMs);
      }
      break;

    case TreeState::RaceActive: {
      for (uint8_t lane = 0; lane < MAX_LANE_COUNT; ++lane) {
        if (!laneParticipates(lane)) continue;
        updateLaneTree(lane, nowMs);
        updateLaneRace(lane);
      }

      const unsigned long latestGreenDelay =
          latestLaneDelayMs() +
          treeGreenDelayMs();
      if (allLanesHaveResults()) {
        prepareRaceResults();
        enterState(TreeState::ShowingResults, nowMs);
      } else if (nowMs - raceEpochMs >=
                 latestGreenDelay + MAX_RACE_TIME_MS) {
        prepareRaceResults();
        enterState(TreeState::ShowingResults, nowMs);
      }
      break;
    }

    case TreeState::ShowingResults:
      if (!raceResultsPending && nowMs - stateStartedAtMs >= RESULT_HOLD_MS) {
        enterState(TreeState::WaitingForClear, nowMs);
      }
      break;

    case TreeState::WaitingForClear:
      if (!allSensorsAreClear()) {
        stateStartedAtMs = nowMs;
      } else if (nowMs - stateStartedAtMs >= TRACK_CLEAR_HOLD_MS) {
        enterState(TreeState::WaitingForAllLanes, nowMs);
      }
      break;
  }
}

void recordScanStart(const unsigned long nowUs) {
  if (scanTimingAvailable) {
    const unsigned long gap = nowUs - previousScanStartedUs;
    if (gap > maximumScanGapUs) maximumScanGapUs = gap;
  }
  previousScanStartedUs = nowUs;
  scanTimingAvailable = true;
}

void scanSensors(const unsigned long nowMs) {
  refreshSensorCaptureScope();
  const unsigned long startedUs = micros();
  recordScanStart(startedUs);
  for (uint8_t lane = 0; lane < MAX_LANE_COUNT; ++lane) {
#ifndef DRAG_DUE_CAPTURE
    const bool selective = treeState == TreeState::RaceActive && !sensorMonitorEnabled;
    if (selective && !laneParticipates(lane)) continue;
    const bool scanIntervals = !selective || laneHasSplitSensors(lane);
#endif
    for (uint8_t sensor = 0; sensor < SENSORS_PER_LANE; ++sensor) {
#ifndef DRAG_DUE_CAPTURE
      if (!scanIntervals && (sensor == Split1Sensor || sensor == Split2Sensor)) continue;
#endif
      // Mega trap/finish use sampled raw edges; Due downstream inputs use ISR edges.
      // Pre-stage/stage qualification is retained on both boards.
      const bool immediate = sensor == SpeedTrapSensor || sensor == FinishSensor
#ifdef DRAG_DUE_CAPTURE
          || sensor == Split1Sensor || sensor == Split2Sensor
#endif
          ;
      if (sensors[lane][sensor].update(nowMs, immediate)) {
        queueChangedSensorDiagnostic(lane, sensor);
      }
#ifdef DRAG_DUE_CAPTURE
      if (serialQueueCount < SERIAL_QUEUE_CAPACITY - SERIAL_DIAGNOSTIC_RESERVED_SLOTS &&
          sensors[lane][sensor].takeNoiseWarning()) {
        char message[88];
        snprintf(message, sizeof(message), "ERROR:SENSOR_CAPTURE_NOISE:LANE:%u:SENSOR:%s", lane + 1, SENSOR_NAMES[sensor]);
        sendProtocolMessage(message);
      }
#endif
    }
  }
  const unsigned long duration = micros() - startedUs;
  if (duration > maximumScanDurationUs) maximumScanDurationUs = duration;
}

}  // namespace

void setup() {
  Serial.begin(115200);
  for (uint8_t lane = 0; lane < MAX_LANE_COUNT; ++lane) {
    laneLightStates[lane] = 0;
    for (uint8_t light = 0; light < LIGHTS_PER_LANE; ++light) {
      pinMode(LIGHT_PINS[lane][light], OUTPUT);
      digitalWrite(LIGHT_PINS[lane][light], LOW);
    }
    for (uint8_t sensor = 0; sensor < SENSORS_PER_LANE; ++sensor) {
      sensors[lane][sensor].begin(SENSOR_PINS[lane][sensor]);
    }
  }
  const unsigned long nowMs = millis();
  sendHello();
  enterState(TreeState::WaitingForAllLanes, nowMs);
  updateStagingLights();
}

void loop() {
  const unsigned long nowMs = millis();
  scanSensors(nowMs);
  updateSensorMonitor(nowMs);
  updateSerialCommands();
  updateSequentialStaging();
  updateStagingLights();
  updateTree(millis());
  updateHeartbeat(nowMs);
  serviceRaceResults();
  serviceSensorDiagnostics();
  serviceSerialOutput();
}
