tekrantz57/Drag/tools/firmware-tests/results.cpp

#include <cassert>
#include <iostream>
#include "../../dragMC/dragMC.ino"

void resetTest(RaceMode mode) {
  Serial.output.clear();
  Serial.input.clear();
  Serial.inputPosition = 0;
  Serial.writeQuota = 1;
  testTimeMs = 0;
  testSubmillisUs = 0;
  testReadCostUs = 0;
  maximumScanGapUs = maximumScanDurationUs = 0;
  scanTimingAvailable = false;
  serialQueueCount = serialQueueHead = serialQueueTail = serialHeadOffset = 0;
  droppedSerialMessageCount = 0;
  raceMode = mode;
  starterButtonMode = startAuthorized = false;
  lightTestEnabled = false;
  stagedDelayMs = DEFAULT_STAGED_DELAY_MS;
  activeLaneCount = 4;
  heatLaneMask = splitLaneMask = 0x0F;
  sensorMonitorEnabled = false;
  sensorMonitorLaneMask = 0x0F;
#ifdef DRAG_DUE_CAPTURE
  dueRaceCaptureArmed = true;
#endif
  enterState(TreeState::WaitingForAllLanes, 0);
  serialQueueCount = serialQueueHead = serialQueueTail = 0;
}

size_t count(const std::string& text, const std::string& value) {
  size_t matches = 0, at = 0;
  while ((at = text.find(value, at)) != std::string::npos) {
    ++matches;
    at += value.size();
  }
  return matches;
}

void drain() {
  for (int iteration = 0; iteration < 100000; ++iteration) {
    serviceRaceResults();
    serviceSerialOutput();
    assert(serialQueueCount <= SERIAL_QUEUE_CAPACITY);
    if (!raceResultsPending && serialQueueCount == 0) return;
  }
  assert(false && "Result delivery did not finish");
}

void command(const std::string& payload) {
  char frame[128];
  snprintf(frame, sizeof(frame), "%s:%02X", payload.c_str(), calculateChecksum(payload.c_str()));
  processCommand(frame);
  drain();
}

void stage(bool blocked) {
  for (uint8_t lane = 0; lane < MAX_LANE_COUNT; ++lane) {
    for (uint8_t sensor = 0; sensor < SENSORS_PER_LANE; ++sensor) {
      testPinLevels[SENSOR_PINS[lane][sensor]] =
          blocked && (sensor == PreStageSensor || sensor == StageSensor) ? HIGH : LOW;
      sensors[lane][sensor] = DebouncedBeamSensor{};
      sensors[lane][sensor].begin(SENSOR_PINS[lane][sensor]);
#ifdef DRAG_DUE_CAPTURE
      // Fixture: establish an already-held staging state without manufacturing edges.
      sensors[lane][sensor].setEnabled(true);
      sensors[lane][sensor].update(0, true);
#endif
    }
  }
}

void starterTests() {
  for (auto mode : {RaceMode::HeadsUp, RaceMode::Bracket}) {
    for (auto tree : {TreeMode::Full, TreeMode::Pro}) {
      resetTest(mode);
      treeMode = tree;
      heatLaneMask = 1;
      stage(false);
      command("ARM:MANUAL");
      command("START_TREE:1");
      assert(!startAuthorized && treeState == TreeState::WaitingForAllLanes);
      stage(true);
      updateTree(0);
      const auto token = stagingToken;
      testTimeMs = 10000;
      updateTree(testTimeMs);
      assert(treeState == TreeState::StagingHold && !startAuthorized);
      command("START_TREE:" + std::to_string(token));
      assert(startAuthorized);
      const auto authorizedAt = stateStartedAtMs;
      testTimeMs += 10;
      command("START_TREE:" + std::to_string(token));
      assert(stateStartedAtMs == authorizedAt);
      updateTree(authorizedAt + stagedDelayMs - 1);
      assert(treeState == TreeState::StagingHold);
      updateTree(authorizedAt + stagedDelayMs);
      assert(treeState == TreeState::RaceActive);

      // Arm is atomic, even when replacing an already active automatic race.
      starterButtonMode = false;
      command("ARM:MANUAL");
      assert(starterButtonMode && treeState == TreeState::WaitingForAllLanes && !startAuthorized);
#ifdef DRAG_DUE_CAPTURE
      testTimeMs += 3;  // Re-arming takes a fresh baseline and requalifies held stage beams.
      scanSensors(testTimeMs);
#endif
      updateTree(testTimeMs);
      command("START_TREE:" + std::to_string(stagingToken));
      assert(startAuthorized);
      stage(false);
      updateTree(testTimeMs);
      assert(treeState == TreeState::WaitingForAllLanes && !startAuthorized);
      stage(true);
      updateTree(testTimeMs);
      const auto restagedToken = stagingToken;
      assert(restagedToken != token);
      command("START_TREE:" + std::to_string(token));
      assert(!startAuthorized);
      lightTestEnabled = true;
      command("START_TREE:" + std::to_string(restagedToken));
      assert(!startAuthorized);
      lightTestEnabled = false;
      stagedDelayMs = 0;
      command("START_TREE:" + std::to_string(restagedToken));
      updateTree(testTimeMs);
      assert(treeState == TreeState::RaceActive);

      command("ARM:AUTO");
      assert(!starterButtonMode);
#ifdef DRAG_DUE_CAPTURE
      testTimeMs += 3;
      scanSensors(testTimeMs);
#endif
      updateTree(testTimeMs);
      updateTree(testTimeMs);
      assert(treeState == TreeState::RaceActive);
      command("START_TREE:" + std::to_string(stagingToken));
      assert(!startAuthorized);
    }
  }
  std::cout << "Firmware starter-button tests passed.\n";
}

void shortPulseTests() {
  for (auto mode : {RaceMode::HeadsUp, RaceMode::Bracket}) {
    resetTest(mode);
    stage(false);
    heatLaneMask = 1;
    splitLaneMask = 0;
    treeState = TreeState::RaceActive;
    lanes[0].launched = true;
    lanes[0].launchedAtUs = 1000;
    testTimeMs = 20;
    testSubmillisUs = 100;
    testPinLevels[A2] = HIGH;
    scanSensors(testTimeMs);
    updateLaneRace(0);
    assert(lanes[0].crossedSpeedTrap && lanes[0].speedTrapAtUs == 20100);
    testSubmillisUs = 500;
    testPinLevels[A2] = LOW;
    scanSensors(testTimeMs);
    updateLaneRace(0);
    assert(sensors[0][SpeedTrapSensor].lastRawPulseWidthUs() == 400);
    testSubmillisUs = 600;
    testPinLevels[A2] = HIGH;
    scanSensors(testTimeMs);
    updateLaneRace(0);
    assert(lanes[0].speedTrapAtUs == 20100);
    testTimeMs = 30;
    testSubmillisUs = 0;
    testPinLevels[A3] = HIGH;
    scanSensors(testTimeMs);
    updateLaneRace(0);
    assert(lanes[0].finished && lanes[0].elapsedUs == 29000);
    testSubmillisUs = 300;
    testPinLevels[A3] = LOW;
    scanSensors(testTimeMs);
    updateLaneRace(0);
    assert(sensors[0][FinishSensor].lastRawPulseWidthUs() == 300);
    testSubmillisUs = 500;
    testPinLevels[A3] = HIGH;
    scanSensors(testTimeMs);
    updateLaneRace(0);
    assert(lanes[0].finishedAtUs == 30000 && lanes[0].elapsedUs == 29000);
    assert(sensors[0][FinishSensor].blockedEdgeCount() == 2);

    // The exact same short pulse must not bypass staging or interval debounce.
    splitLaneMask = 1;
    testTimeMs = 40;
    testSubmillisUs = 0;
    testPinLevels[A0] = testPinLevels[A1] = testPinLevels[2] = HIGH;
    scanSensors(testTimeMs);
    assert(!sensors[0][PreStageSensor].isBlocked() && !sensors[0][StageSensor].isBlocked());
    assert(!sensors[0][Split1Sensor].isBlocked());
    testSubmillisUs = 500;
    testPinLevels[A0] = testPinLevels[A1] = testPinLevels[2] = LOW;
    scanSensors(testTimeMs);
    assert(!sensors[0][StageSensor].becameBlocked());
    testTimeMs = 41;
    testSubmillisUs = 0;
    testPinLevels[A0] = testPinLevels[A1] = HIGH;
    scanSensors(testTimeMs);
    testTimeMs = 43;
    scanSensors(testTimeMs);
    assert(sensors[0][PreStageSensor].isBlocked() && sensors[0][StageSensor].isBlocked());
  }

  resetSensorDiagnostics();
  recordScanStart(ULONG_MAX - 15UL);
  recordScanStart(20);
  assert(maximumScanGapUs == 36);
  recordScanStart(100);
  assert(maximumScanGapUs == 80);
  resetSensorDiagnostics();
  assert(!scanTimingAvailable && maximumScanGapUs == 0 && maximumScanDurationUs == 0);
  testReadCostUs = 4;
  treeState = TreeState::WaitingForClear;
  scanSensors(testTimeMs);
  assert(maximumScanDurationUs == MAX_LANE_COUNT * SENSORS_PER_LANE * 4);
  testReadCostUs = 0;
  const auto gap = maximumScanGapUs;
  const auto duration = maximumScanDurationUs;
  command("SCAN_DIAGNOSTICS");
  assert(Serial.output.find("STATUS:SCAN:MAX_GAP_US:" + std::to_string(gap) +
      ":MAX_DURATION_US:" + std::to_string(duration)) != std::string::npos);
  std::cout << "Short-pulse capture and scan timing tests passed.\n";
}

void lightCacheTests() {
  setup();
  for (uint8_t lane = 0; lane < MAX_LANE_COUNT; ++lane) {
    for (uint8_t light = 0; light < LIGHTS_PER_LANE; ++light) {
      const auto pin = LIGHT_PINS[lane][light];
      assert(testOutputLevels[pin] == LOW);
      assert(testOutputWrites[pin] == 1);
    }
  }
  const auto pin = LIGHT_PINS[0][GreenLight];
  setLaneLight(0, GreenLight, false);
  assert(testOutputWrites[pin] == 1);
  setLaneLight(0, GreenLight, true);
  setLaneLight(0, GreenLight, true);
  assert(testOutputLevels[pin] == HIGH && testOutputWrites[pin] == 2);
  resetTest(RaceMode::HeadsUp);
  command("LIGHT_TEST:START");
  assert(testOutputLevels[pin] == LOW && testOutputWrites[pin] == 3);
  command("LIGHT_TEST:SET:1:GREEN:1");
  command("LIGHT_TEST:SET:1:GREEN:1");
  assert(testOutputLevels[pin] == HIGH && testOutputWrites[pin] == 4);
  command("LIGHT_TEST:STOP");
  assert(testOutputLevels[pin] == LOW && testOutputWrites[pin] == 5);
  turnOffAllLights();
  assert(testOutputWrites[pin] == 5);
  std::cout << "Light output cache tests passed.\n";
}

#ifndef DRAG_DUE_CAPTURE
void selectiveRaceScanTests() {
  resetTest(RaceMode::HeadsUp);
  stage(false);
  treeState = TreeState::RaceActive;
  activeLaneCount = 4;
  heatLaneMask = 1;
  splitLaneMask = 0;
  sensorMonitorEnabled = false;
  std::fill(std::begin(testPinReads), std::end(testPinReads), 0);
  scanSensors(0);
  for (uint8_t lane = 0; lane < MAX_LANE_COUNT; ++lane) {
    for (uint8_t sensor = 0; sensor < SENSORS_PER_LANE; ++sensor) {
      const bool expected = lane == 0 && sensor != Split1Sensor && sensor != Split2Sensor;
      assert(testPinReads[SENSOR_PINS[lane][sensor]] == (expected ? 1U : 0U));
    }
  }
  // Finish must remain detectable even if no speed-trap pulse was seen.
  lanes[0].launched = true;
  lanes[0].launchedAtUs = 1;
  testPinLevels[A3] = HIGH;
  testTimeMs = 10;
  scanSensors(testTimeMs);
  updateLaneRace(0);
  assert(lanes[0].finished && !lanes[0].crossedSpeedTrap);

  splitLaneMask = 1;
  std::fill(std::begin(testPinReads), std::end(testPinReads), 0);
  scanSensors(testTimeMs);
  assert(testPinReads[2] == 1 && testPinReads[3] == 1);
  heatLaneMask = 0x0f;
  splitLaneMask = 0;
  std::fill(std::begin(testPinReads), std::end(testPinReads), 0);
  scanSensors(testTimeMs);
  for (uint8_t lane = 0; lane < MAX_LANE_COUNT; ++lane)
    assert(testPinReads[SENSOR_PINS[lane][FinishSensor]] == 1);
  assert(testPinReads[2] == 0);
  heatLaneMask = 1;
  sensorMonitorEnabled = true;
  std::fill(std::begin(testPinReads), std::end(testPinReads), 0);
  scanSensors(testTimeMs);
  for (uint8_t lane = 0; lane < MAX_LANE_COUNT; ++lane)
    for (uint8_t sensor = 0; sensor < SENSORS_PER_LANE; ++sensor)
      assert(testPinReads[SENSOR_PINS[lane][sensor]] == 1);
  // Lane settings cannot be changed while the selective race scan is active.
  resetTest(RaceMode::HeadsUp);
  stage(false);
  treeState = TreeState::RaceActive;
  activeLaneCount = 4;
  heatLaneMask = 1;
  lanes[0].launched = lanes[1].launched = true;
  testPinLevels[A7] = HIGH;
  const char* setting = "SET:HEAT_LANES:1,2";
  char frame[64];
  snprintf(frame, sizeof(frame), "%s:%02X\n", setting, calculateChecksum(setting));
  Serial.input = frame;
  while (Serial.available()) loop();
  assert(heatLaneMask == 1 && !lanes[1].finished);
  drain();
  assert(Serial.output.find("ERROR:STATE:RACE_ACTIVE") != std::string::npos);
  Serial.input.clear();
  Serial.inputPosition = 0;
  setting = "SENSOR_MONITOR:START:2";
  snprintf(frame, sizeof(frame), "%s:%02X\n", setting, calculateChecksum(setting));
  Serial.input = frame;
  while (Serial.available()) loop();
  loop(); // Monitoring becomes full on the next scan, preserving current-loop edges.
  assert(sensorMonitorEnabled && sensors[1][FinishSensor].isRawBlocked());
  testPinLevels[A7] = LOW;
  // Opening monitoring must not erase a finish edge seen in the same loop.
  resetTest(RaceMode::HeadsUp);
  stage(false);
  treeState = TreeState::RaceActive;
  heatLaneMask = 1;
  lanes[0].launched = true;
  setting = "SENSOR_MONITOR:START:1";
  snprintf(frame, sizeof(frame), "%s:%02X\n", setting, calculateChecksum(setting));
  Serial.input = frame;
  while (Serial.available() > MAX_SERIAL_INPUT_BYTES_PER_LOOP) loop();
  testPinLevels[A3] = HIGH;
  loop();
  assert(lanes[0].finished && sensorMonitorEnabled);
  sensorMonitorEnabled = false;
  treeState = TreeState::WaitingForClear;
  std::fill(std::begin(testPinReads), std::end(testPinReads), 0);
  scanSensors(testTimeMs);
  for (uint8_t lane = 0; lane < MAX_LANE_COUNT; ++lane)
    for (uint8_t sensor = 0; sensor < SENSORS_PER_LANE; ++sensor)
      assert(testPinReads[SENSOR_PINS[lane][sensor]] == 1);
  testPinLevels[A3] = LOW;
  std::cout << "Selective race scan tests passed.\n";
}

void heartbeatQuietTests() {
  resetTest(RaceMode::HeadsUp);
  heartbeatQuiet = false;
  lastHeartbeatAtMs = 0;
  starterButtonMode = true;
  treeState = TreeState::StagingHold;
  startAuthorized = false;
  updateHeartbeat(1000);
  drain();
  assert(Serial.output.find("HEARTBEAT:") != std::string::npos);
  Serial.output.clear();
  startAuthorized = true;
  updateHeartbeat(2000);
  updateHeartbeat(3000);
  drain();
  assert(count(Serial.output, "HEARTBEAT_QUIET") == 1);
  assert(Serial.output.find("HEARTBEAT:3000") == std::string::npos);
  Serial.output.clear();
  treeState = TreeState::RaceActive;
  updateHeartbeat(4000);
  drain();
  assert(Serial.output.empty());
  treeState = TreeState::ShowingResults;
  updateHeartbeat(4001);
  drain();
  assert(Serial.output.find("HEARTBEAT:4001") != std::string::npos);
  Serial.output.clear();
  treeState = TreeState::StagingHold;
  starterButtonMode = false;
  updateHeartbeat(5000);
  drain();
  assert(count(Serial.output, "HEARTBEAT_QUIET") == 1);
  Serial.output.clear();
  treeState = TreeState::WaitingForAllLanes;
  updateHeartbeat(5001);
  drain();
  assert(Serial.output.find("HEARTBEAT:5001") != std::string::npos);
  std::cout << "Heartbeat quiet/resume tests passed.\n";
}
#endif

int main() {
  lightCacheTests();
  assert(DragBoard::validPinMap());
#ifndef DRAG_DUE_CAPTURE
  selectiveRaceScanTests();
  heartbeatQuietTests();
  shortPulseTests();
#endif
  starterTests();
  for (RaceMode mode : {RaceMode::HeadsUp, RaceMode::Bracket}) {
    resetTest(mode);
    for (uint8_t lane = 0; lane < MAX_LANE_COUNT; ++lane) {
      lanes[lane].launched = lanes[lane].finished = true;
      lanes[lane].launchedAtUs = 1000;
      lanes[lane].finishedAtUs = 10001000UL + lane;
      prepareElapsedResult(lane);
    }
    // Begin with no room at all, then drain one byte per polling iteration.
    for (uint8_t slot = 0; slot < SERIAL_QUEUE_CAPACITY; ++slot)
      assert(queueProtocolMessage("ACK:PING"));
    prepareRaceResults();
    enterState(TreeState::ShowingResults, 0);
    serviceRaceResults();
    assert(resultFieldCursor[0] == 0);
    testTimeMs = RESULT_HOLD_MS + 100;
    updateTree(testTimeMs);
    assert(treeState == TreeState::ShowingResults);
    drain();
    assert(droppedSerialMessageCount == 0);
    assert(count(Serial.output, ":ELAPSED_US:") == 4);
    assert(count(Serial.output, ":INTERVAL_1_UNAVAILABLE:") == 4);
    assert(count(Serial.output, ":INTERVAL_2_UNAVAILABLE:") == 4);
    assert(count(Serial.output, "RESULT:PLACE:") == 4);
    assert(count(Serial.output, "EVENT:TREE:RACE_COMPLETE:") == 1);
    assert(Serial.output.rfind("EVENT:TREE:RACE_COMPLETE:") > Serial.output.rfind("RESULT:"));
    assert(count(Serial.output, "RESULT:WINNER:") == (mode == RaceMode::Bracket ? 1 : 0));
  }

  resetTest(RaceMode::Bracket);
  treeState = TreeState::RaceActive;
  lanes[0].launched = lanes[0].finished = true;
  lanes[0].finishedAtUs = 10000000UL;
  prepareElapsedResult(0);
  drain();
  assert(count(Serial.output, ":ELAPSED_US:") == 1);
  assert(count(Serial.output, "RACE_COMPLETE") == 0);

  for (bool foul : {false, true}) {
    resetTest(RaceMode::Bracket);
    for (auto& lane : lanes) {
      lane.fouled = foul;
      lane.reactionAvailable = foul;
      lane.reactionUs = -1000;
    }
    prepareRaceResults();
    enterState(TreeState::ShowingResults, 0);
    drain();
    assert(count(Serial.output, "EVENT:TREE:RACE_COMPLETE:") == 1);
    assert(count(Serial.output, ":DNF:") == (foul ? 0 : 4));
    assert(count(Serial.output, ":FOUL:") == (foul ? 4 : 0));
    assert(count(Serial.output, "RESULT:NO_WINNER:") == (foul ? 0 : 1));
  }

  resetTest(RaceMode::Bracket);
  prepareRaceResults();
  enterState(TreeState::WaitingForAllLanes, 0);
  assert(!raceResultsPending);
  std::cout << "Firmware result delivery tests passed.\n";
  return 0;
}
