tekrantz57/Drag/tools/firmware-tests/Arduino.h

#pragma once

#include <algorithm>
#include <cstdint>
#include <cstdio>
#include <cstdlib>
#include <cstring>
#include <string>

using std::min;
using PGM_P = const char*;
#define PSTR(value) value
#define strcmp_P strcmp
#define strncmp_P strncmp
#define strncpy_P strncpy
#define snprintf_P snprintf
#ifdef _MSC_VER
#define strtok_r strtok_s
#endif
constexpr int HIGH = 1, LOW = 0, INPUT = 0, INPUT_PULLUP = 2, OUTPUT = 1;
constexpr uint8_t A0 = 54, A1 = 55, A2 = 56, A3 = 57;
constexpr uint8_t A4 = 58, A5 = 59, A6 = 60, A7 = 61;
constexpr uint8_t A8 = 62, A9 = 63, A10 = 64, A11 = 65;
constexpr uint8_t A12 = 66, A13 = 67, A14 = 68, A15 = 69;
inline unsigned long testTimeMs = 0;
inline unsigned long testSubmillisUs = 0;
inline unsigned long millis() { return testTimeMs; }
inline unsigned long micros() { return testTimeMs * 1000UL + testSubmillisUs; }
inline void pinMode(uint8_t, int) {}
inline int testOutputLevels[256] = {};
inline unsigned testOutputWrites[256] = {};
inline void digitalWrite(uint8_t pin, int level) {
  testOutputLevels[pin] = level;
  ++testOutputWrites[pin];
}
inline int testPinLevels[256] = {};
inline unsigned testPinReads[256] = {};
inline unsigned long testReadCostUs = 0;
inline int digitalRead(uint8_t pin) {
  ++testPinReads[pin];
  testSubmillisUs += testReadCostUs;
  return testPinLevels[pin];
}

#ifdef DRAG_TEST_DUE
constexpr int CHANGE = 3;
inline uint32_t testInterruptMask = 0;
inline void (*testInterruptCallbacks[66])() = {};
inline uint32_t __get_PRIMASK() { return testInterruptMask; }
inline void __disable_irq() { testInterruptMask = 1; }
inline void __set_PRIMASK(uint32_t value) { testInterruptMask = value; }
inline int digitalPinToInterrupt(uint8_t pin) { return pin; }
inline void attachInterrupt(int pin, void (*callback)(), int) { testInterruptCallbacks[pin] = callback; }
inline void detachInterrupt(int pin) { testInterruptCallbacks[pin] = nullptr; }
#endif

struct TestSerial {
  std::string output;
  std::string input;
  size_t inputPosition = 0;
  int writeQuota = 1;
  void begin(int) {}
  int available() { return static_cast<int>(input.size() - inputPosition); }
  int read() { return inputPosition < input.size() ? static_cast<unsigned char>(input[inputPosition++]) : -1; }
  int availableForWrite() { return writeQuota; }
  void write(const uint8_t* bytes, size_t length) {
    output.append(reinterpret_cast<const char*>(bytes), length);
  }
};
inline TestSerial Serial;
