tekrantz57/Drag/(commit log)

2026-06-28 Add persistent bracket tournament runner
2026-07-15 Flip LM393 sensor polarity
    [dragMC.ino]
2026-07-19 Add sensor test UI
2026-07-19 Document sensor wiring pulldowns
2026-07-19 Document optional sensor board resistor mod
2026-07-19 Note reference Mega sensor test rig
2026-07-22 Add sensor pulse diagnostics
2026-07-25 Document lane one track testing milestone
2026-07-25 Prevent serial diagnostics UI stalls
2026-07-26 Add optional interval timer sensors
2026-08-03 Improve live sensor diagnostics
2026-08-03 Document one-lane tree prototype
2026-09-24 Document ESP32-S31 controller option
2026-10-06 Normalize ZIP entry paths across PowerShell runtimes
2026-10-06 Load archive types explicitly for Windows PowerShell
2026-10-18 Add optional starter-button control for practice and tournaments
